topoppe/open-wales/README.md

# open-wales
Open-WaLeS: Ein Open-Source-IoT-System zur kurz- und langfristigen Überwachung von Binnenpegeln

Welcome to the official Github-Repo of the Open-WaLeS-System
