topoppe/open-wales/Basismodule/lorawan/firmware/readme.md

Sensor Firmware for LoRaWan Transmitter

Own Datatypes: 
0x00 -> 8 Bit FW-Version
0x01 -> 32 Bit Air-Pressure-Value 
0x02 -> 32 Bit Temperature-Value
0x03 -> 32 Bit Humidity-Value
