topoppe/open-wales/Sensormodule/Case/Sensormodul_Oberteil.stl

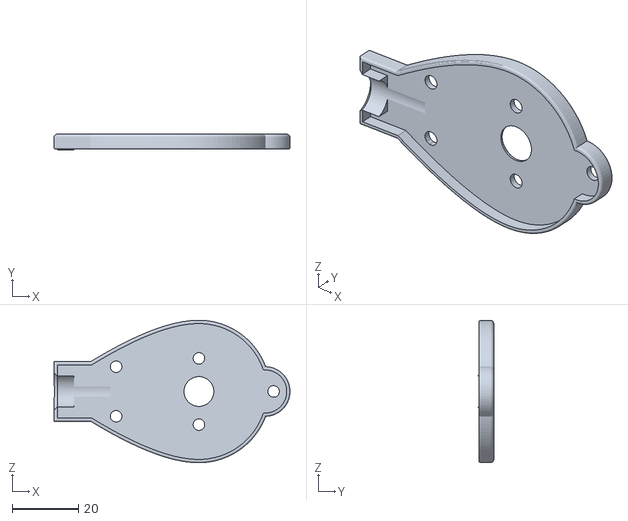
[picture p1: CAD file, 2023-01-30]
Sensormodule/Case/Sensormodul_Oberteil.stl
71.2 x 4.73 x 43.0
