topoppe/open-wales/Sensormodule/Case/Sensormodul_Unterteil.stl

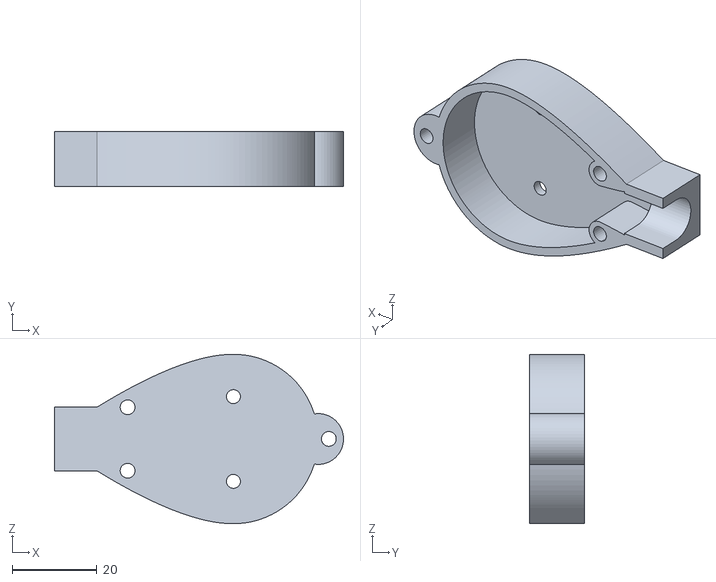
[picture p2: CAD file, 2023-01-30]
Sensormodule/Case/Sensormodul_Unterteil.stl
68.2 x 13.0 x 40.0
