topoppe/open-wales/Sensormodule/Case/Sensormodul_Rohr.stl

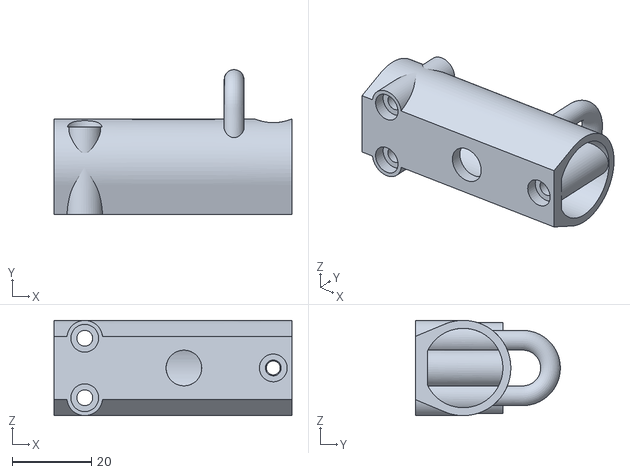
[picture p3: CAD file, 2023-01-30]
Sensormodule/Case/Sensormodul_Rohr.stl
60.0 x 36.5 x 24.0
