topoppe/open-wales/(list of files, cad)

Other CAD files:
Sensormodule/Case/sensor_case.f3d
