topoppe/open-wales/RS485_Interface/schematics_rs485_interface.pdf

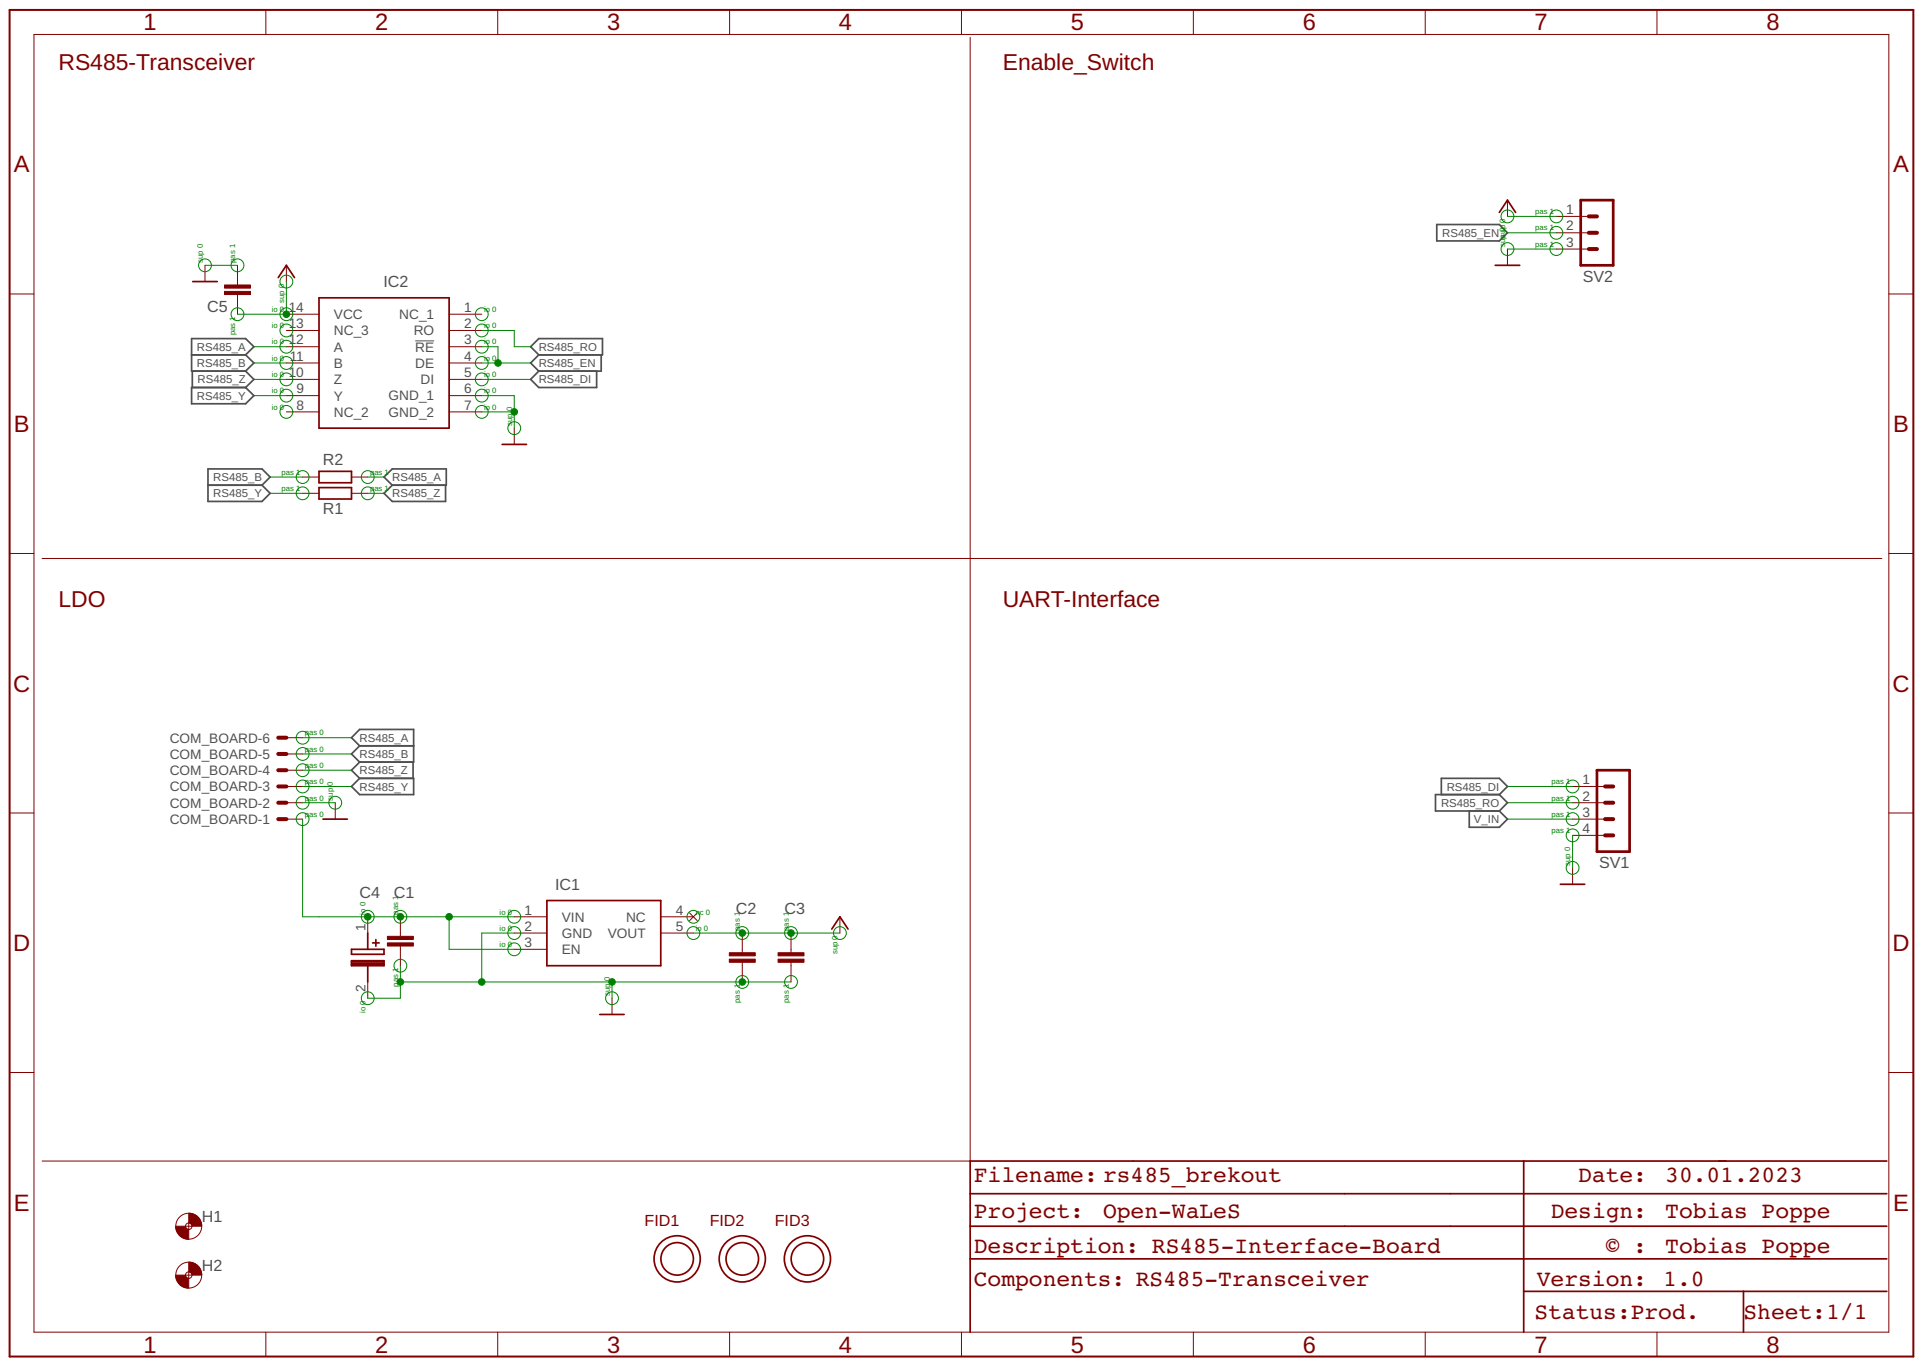
[picture p4: page 1]

Project: Open-WaLeS | Design: Tobias Poppe
Description: RS485-Interface-Board | © : Tobias Poppe
Components: RS485-Transceiver | Version: 1.0

Status: Prod. | Sheet: 1/1
