topoppe/open-wales/Basismodule/lorawan/schematics_basestation_lorawan.pdf

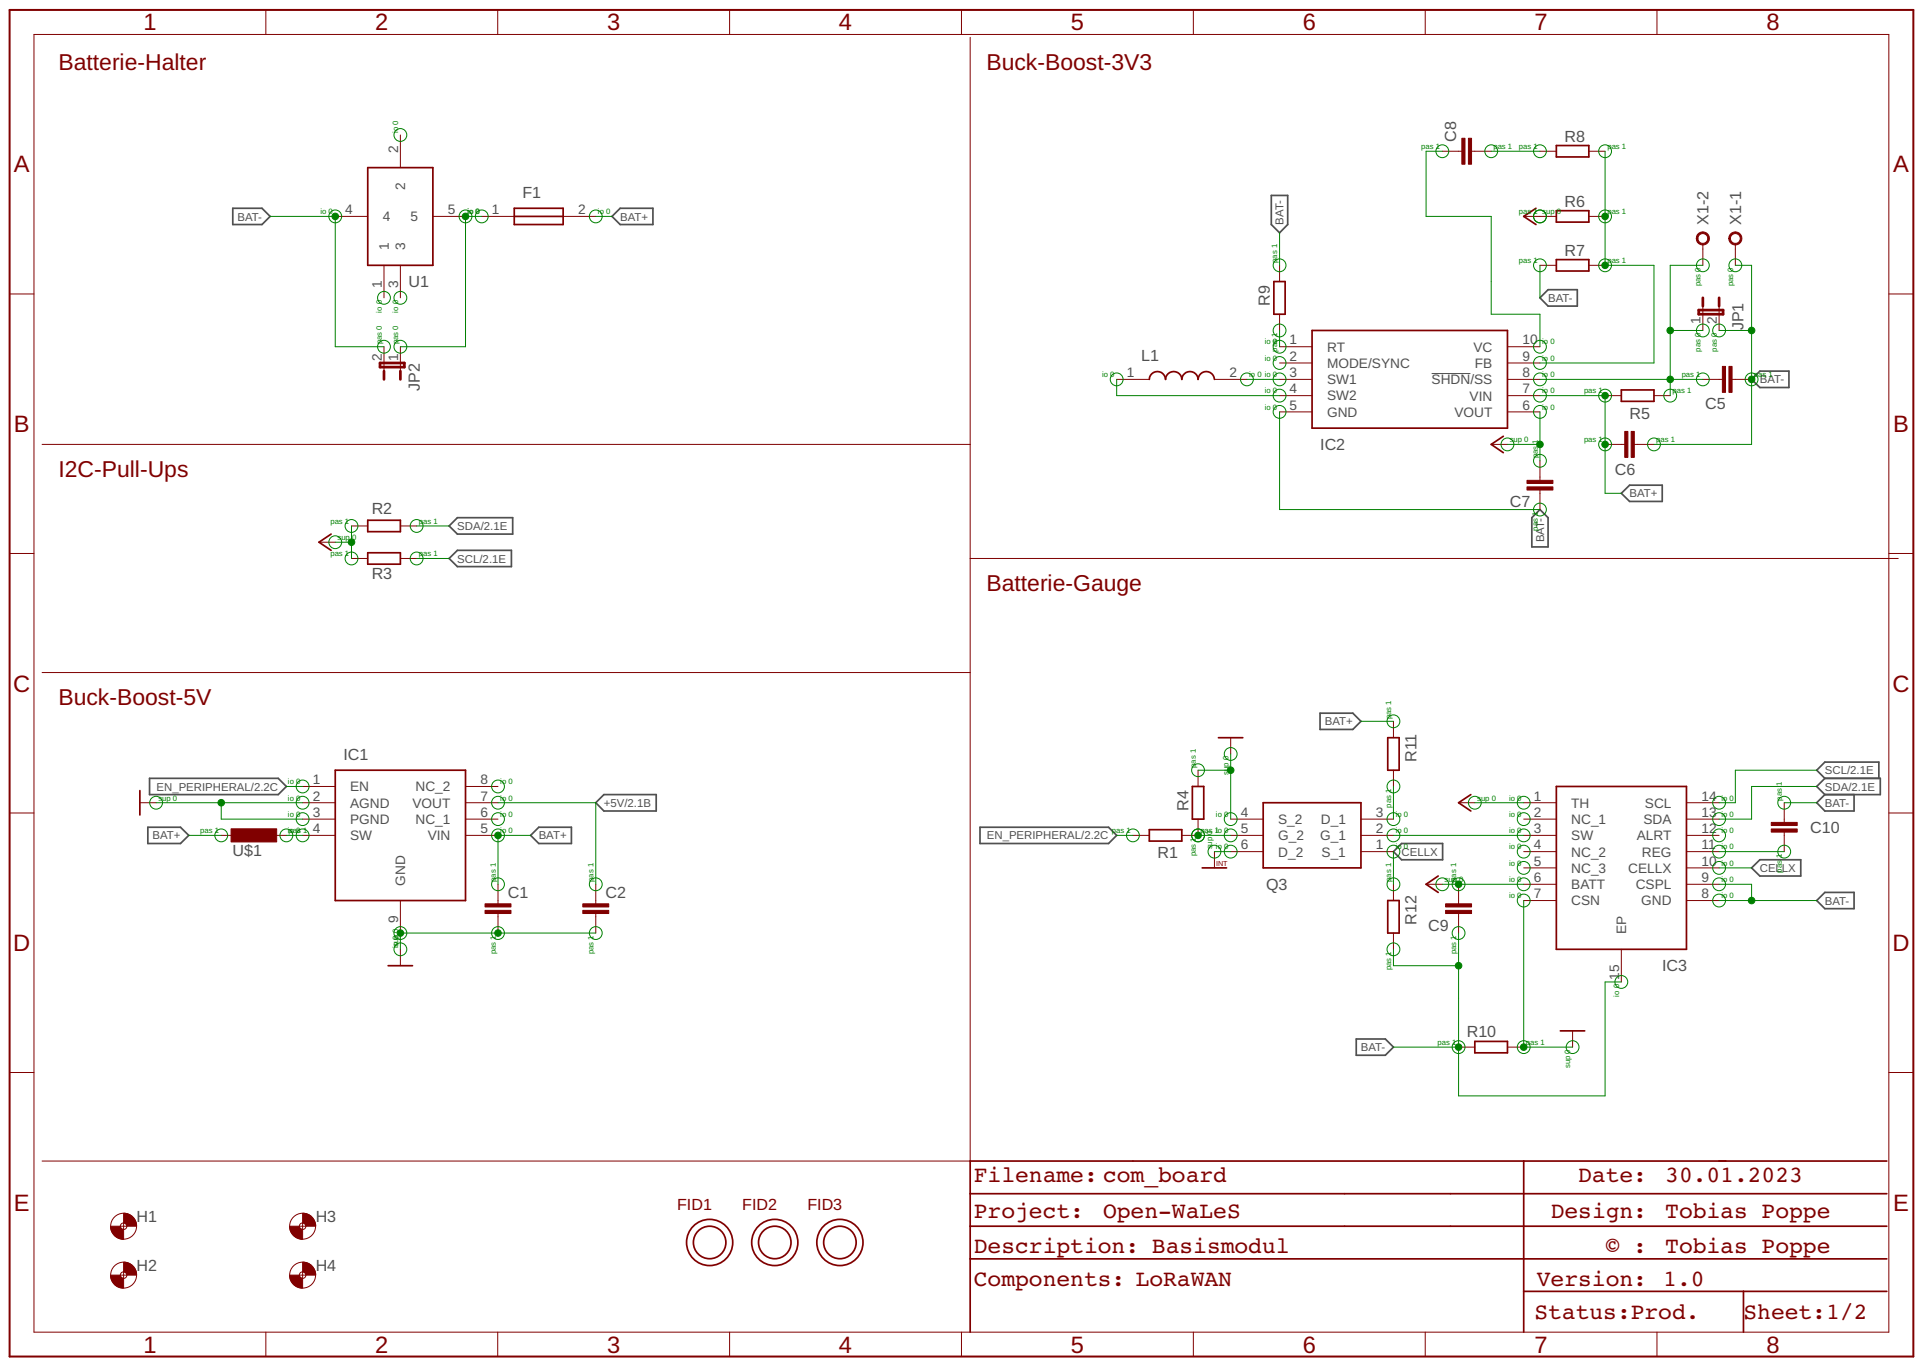
[picture p5: page 1]

pas 1 pas 1

Project: Open-WaLeS | Design: Tobias Poppe
Description: Basismodul | © : Tobias Poppe
Components: LoRaWAN | Version: 1.0

Status: Prod. | Sheet: 1/2

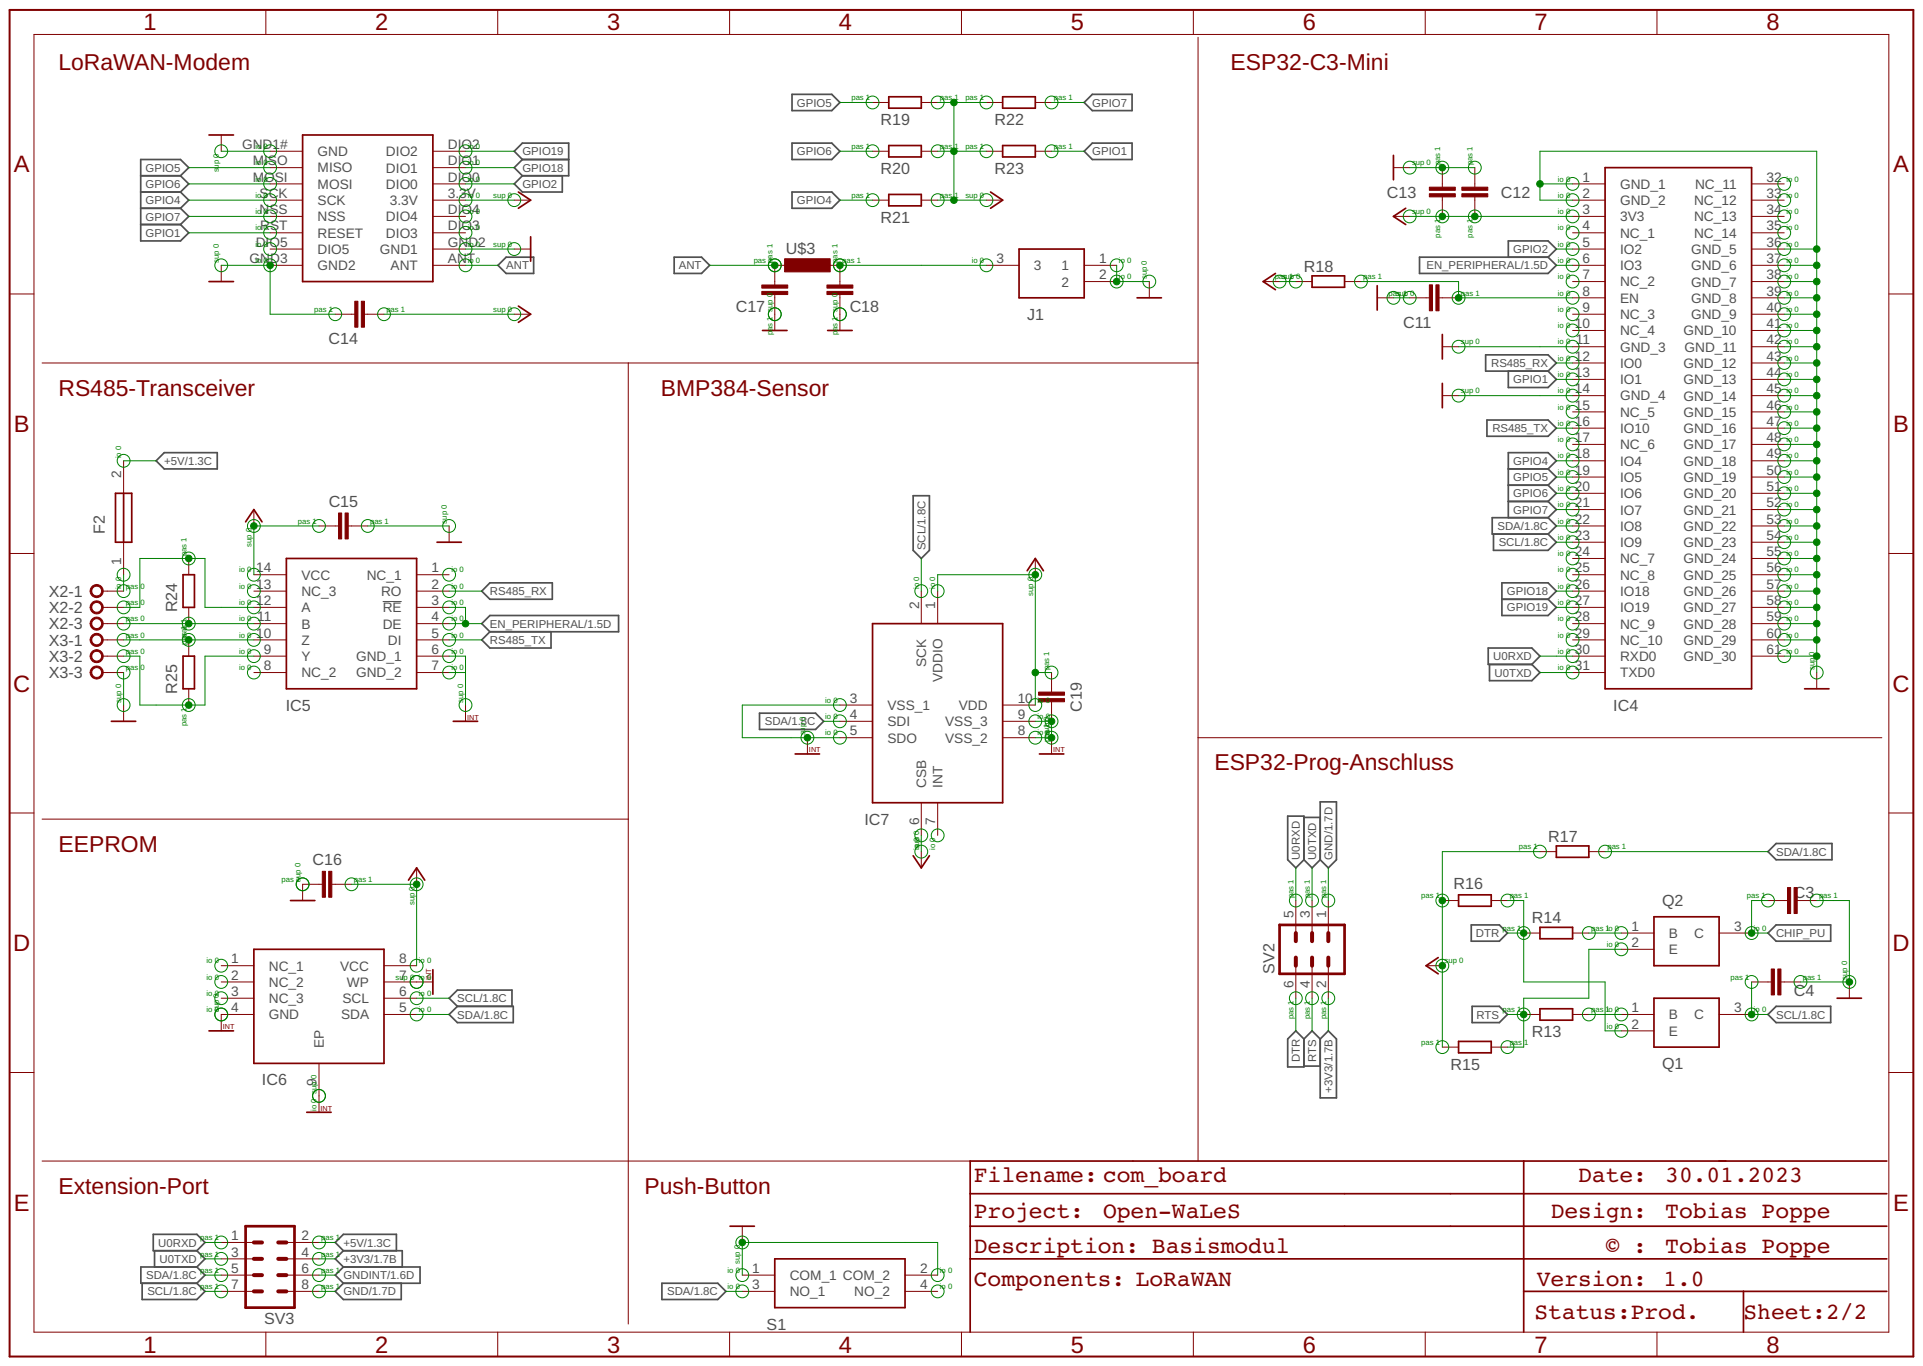
[picture p6: page 2]

LoRaWAN-Modem

pas 1 pas 1

Project: Open-WaLeS | Design: Tobias Poppe
Description: Basismodul | © : Tobias Poppe

SDA/1.8C | GNDINT/1.6D
SCL/1.8C | GND/1.7D

Status: Prod. | Sheet: 2/2
