topoppe/open-wales/Basismodule/nbiot/schematics_basestation_nbiot.pdf

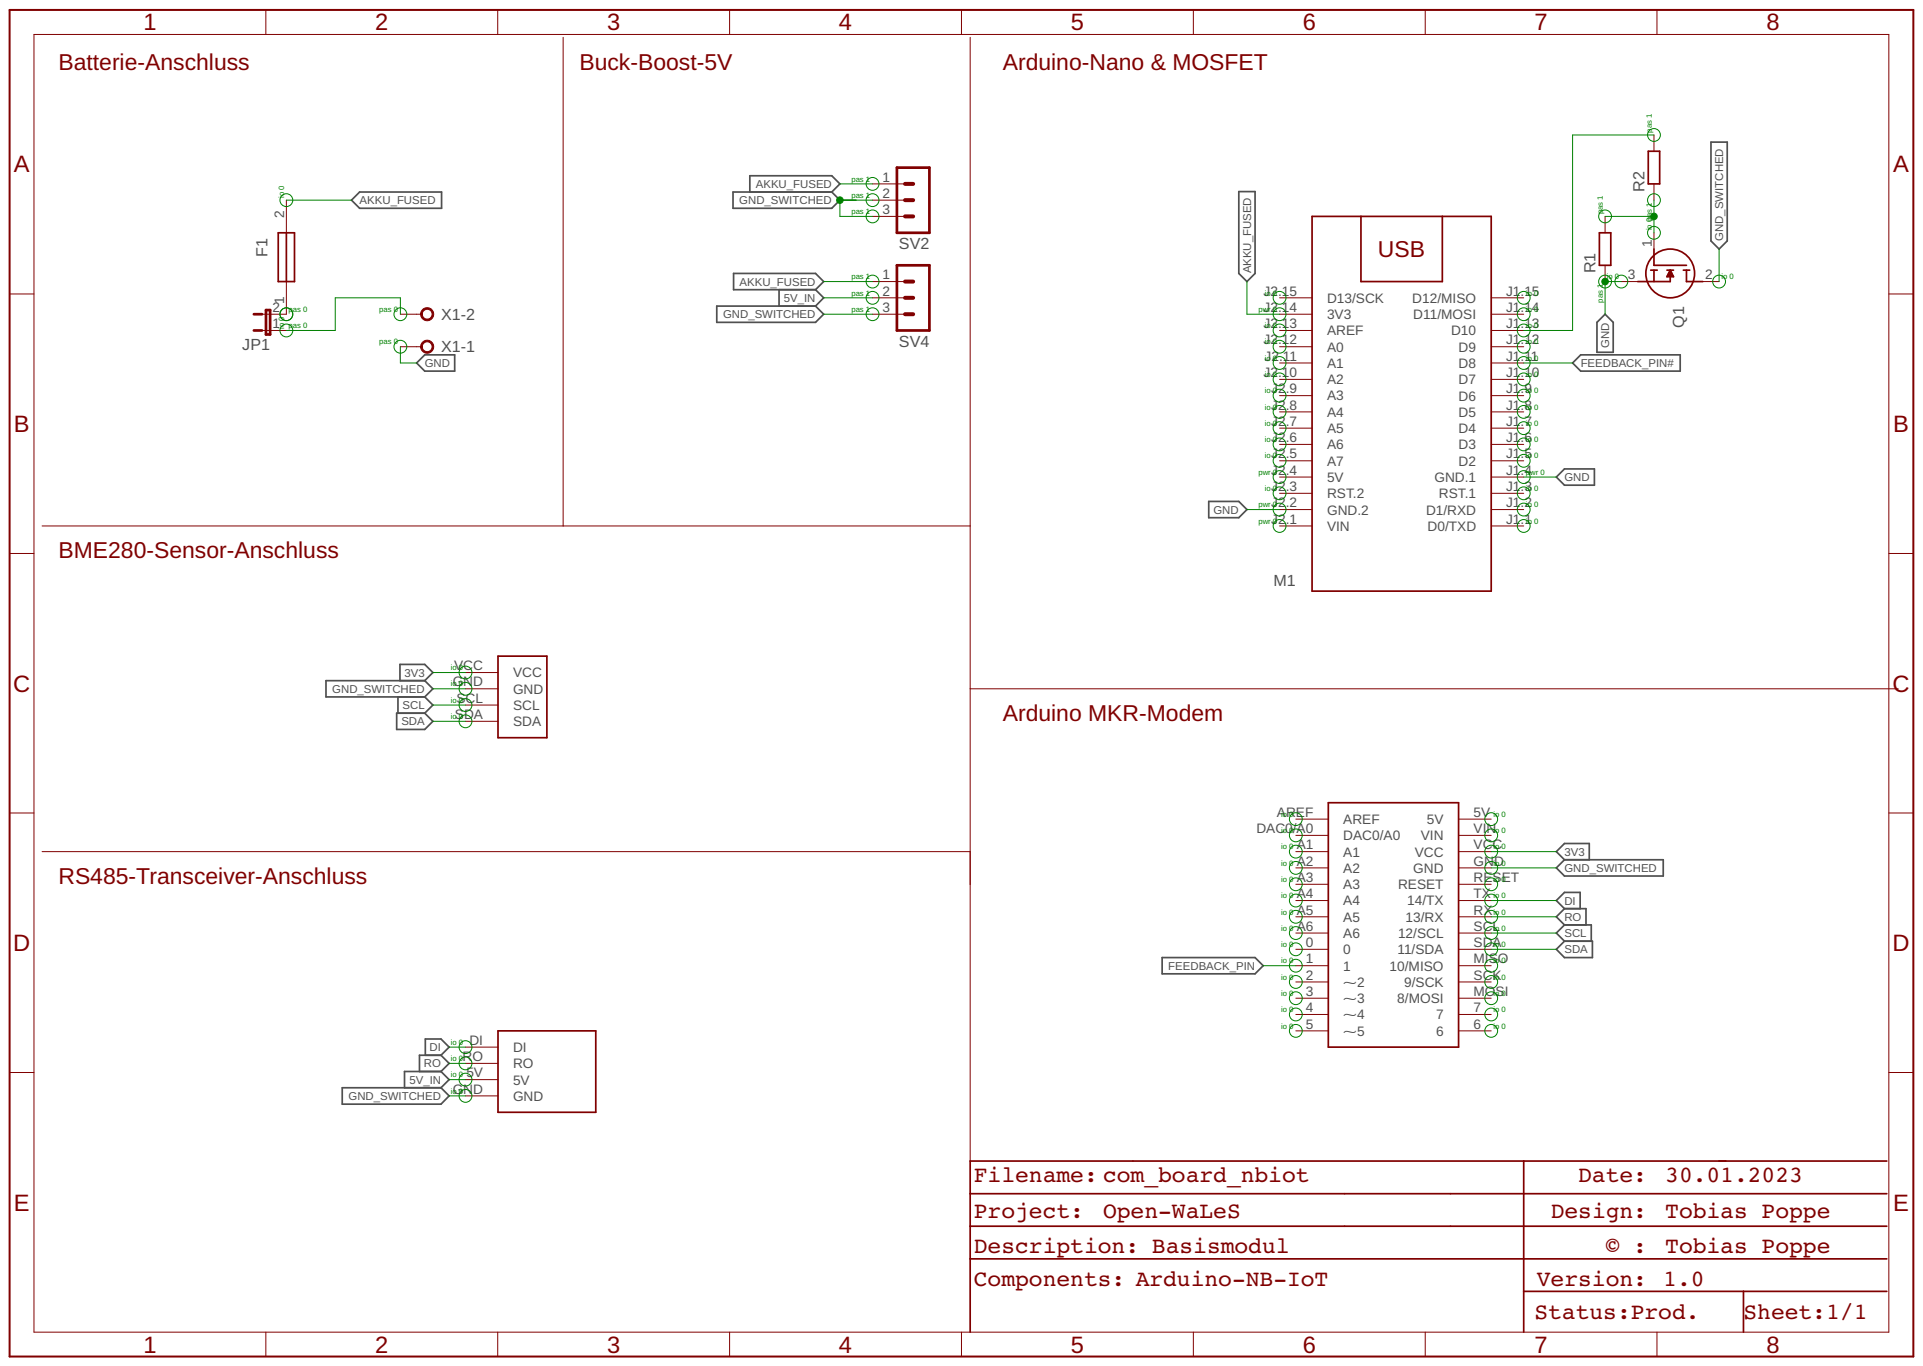
[picture p7: page 1]

Filename: com_board_nbiot | Date: 30.01.2023
Project: Open-WaLeS | Design: Tobias Poppe
Description: Basismodul | © : Tobias Poppe
Components: Arduino-NB-IoT | Version: 1.0

Status: Prod. | Sheet: 1/1
