topoppe/open-wales/Sensormodule/LPS28DFW/schematics_LPS28DFW.pdf

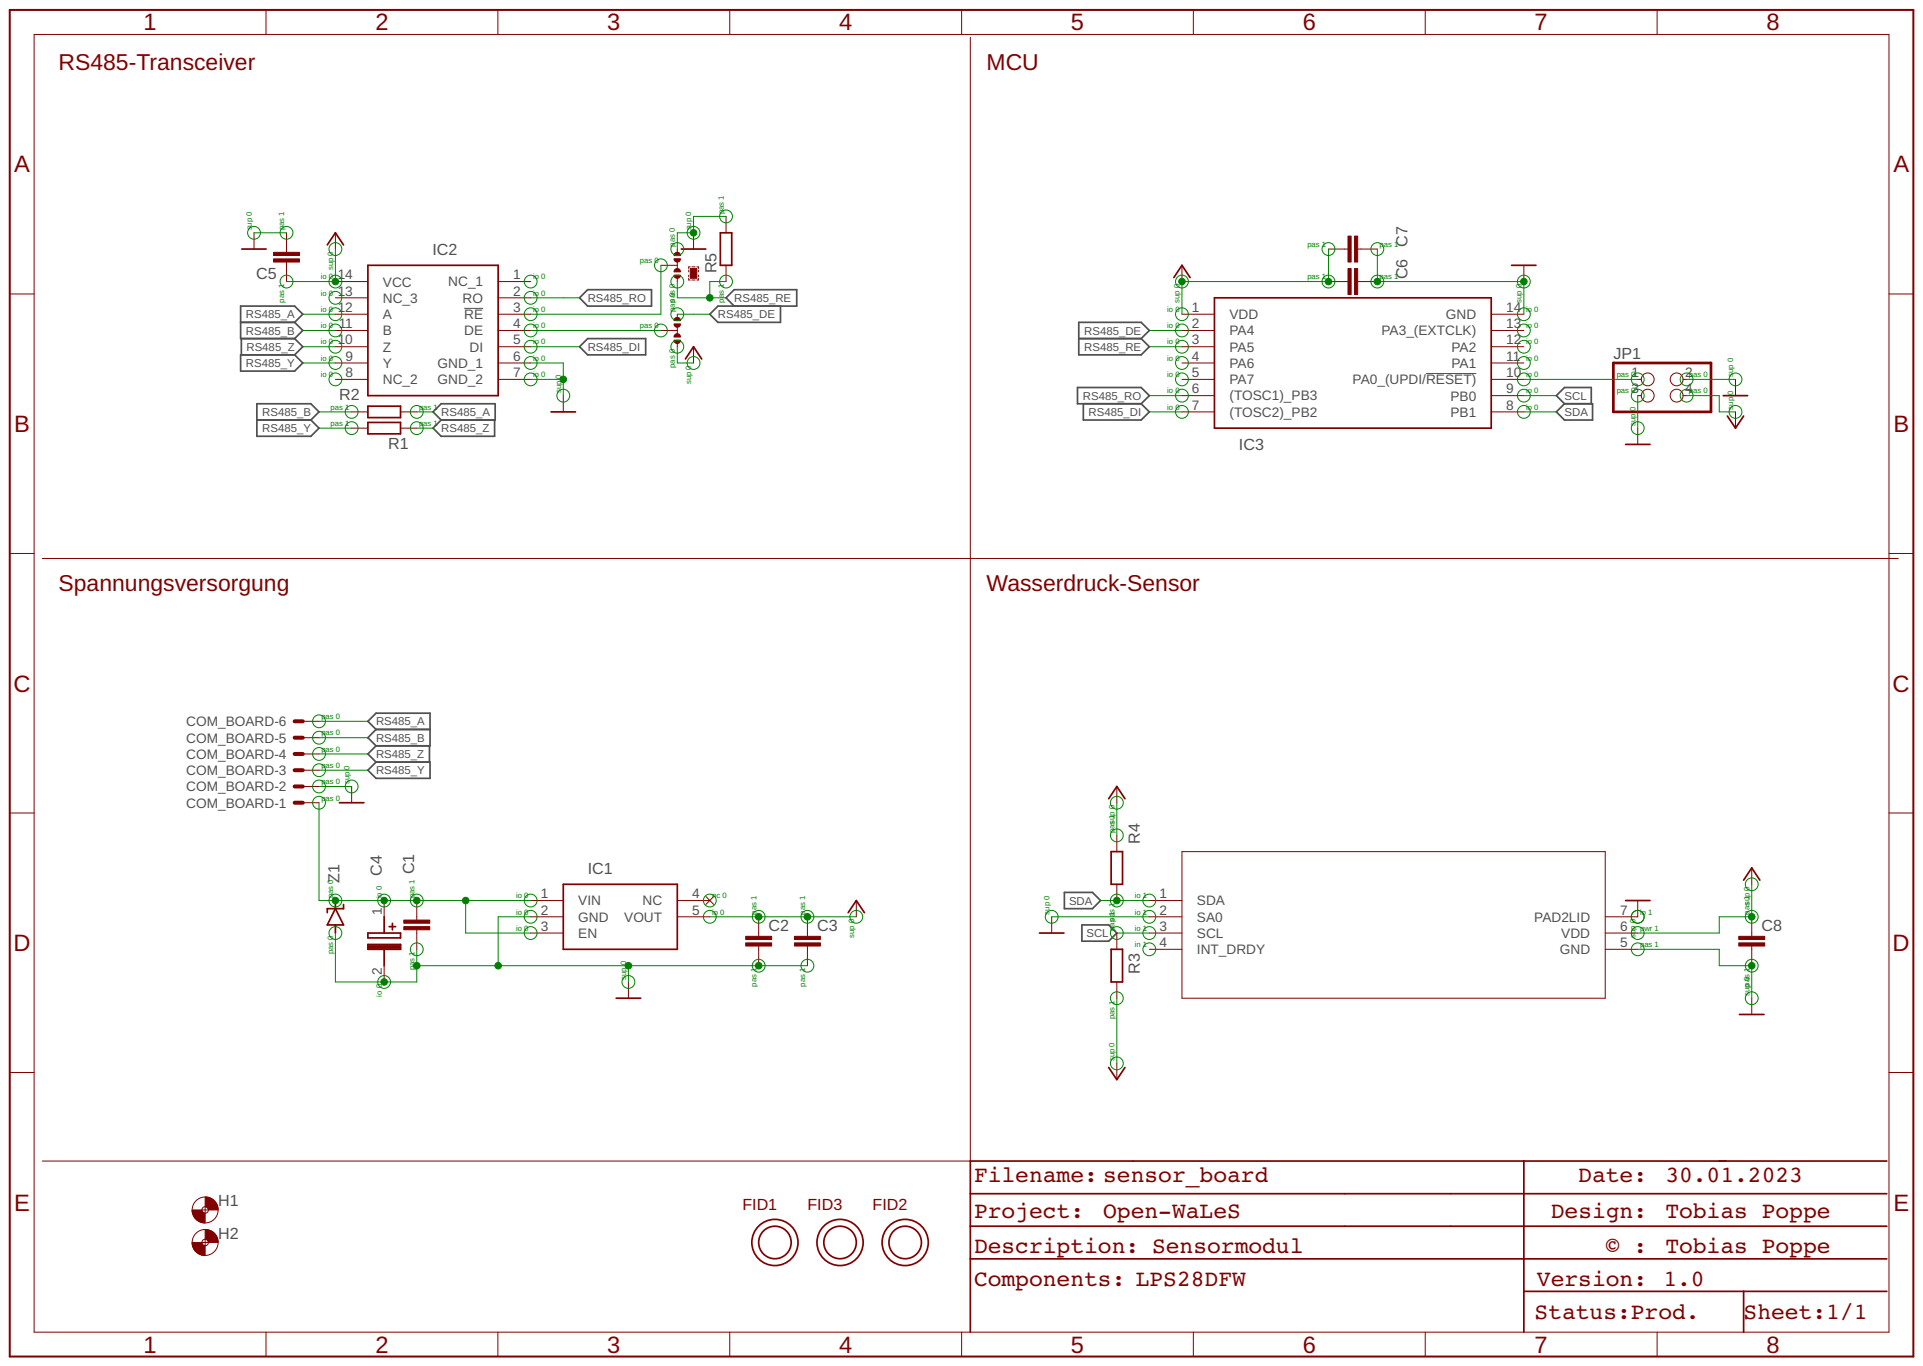
[picture p8: page 1]

pas 1 pas 1 pas 1 pas 1 sup 0 sup 0

pas 1 pas 1 sup 0 sup 0

H1 FID1 FID3 FID2 H2 | Filename: sensor_board | Date: 30.01.2023

Project: Open-WaLeS | Design: Tobias Poppe
Description: Sensormodul | © : Tobias Poppe
Components: LPS28DFW | Version: 1.0

Status: Prod. | Sheet: 1/1
