topoppe/open-wales/Sensormodule/MS5839/with_trubidity/schematics_ms5839_with_trub.pdf

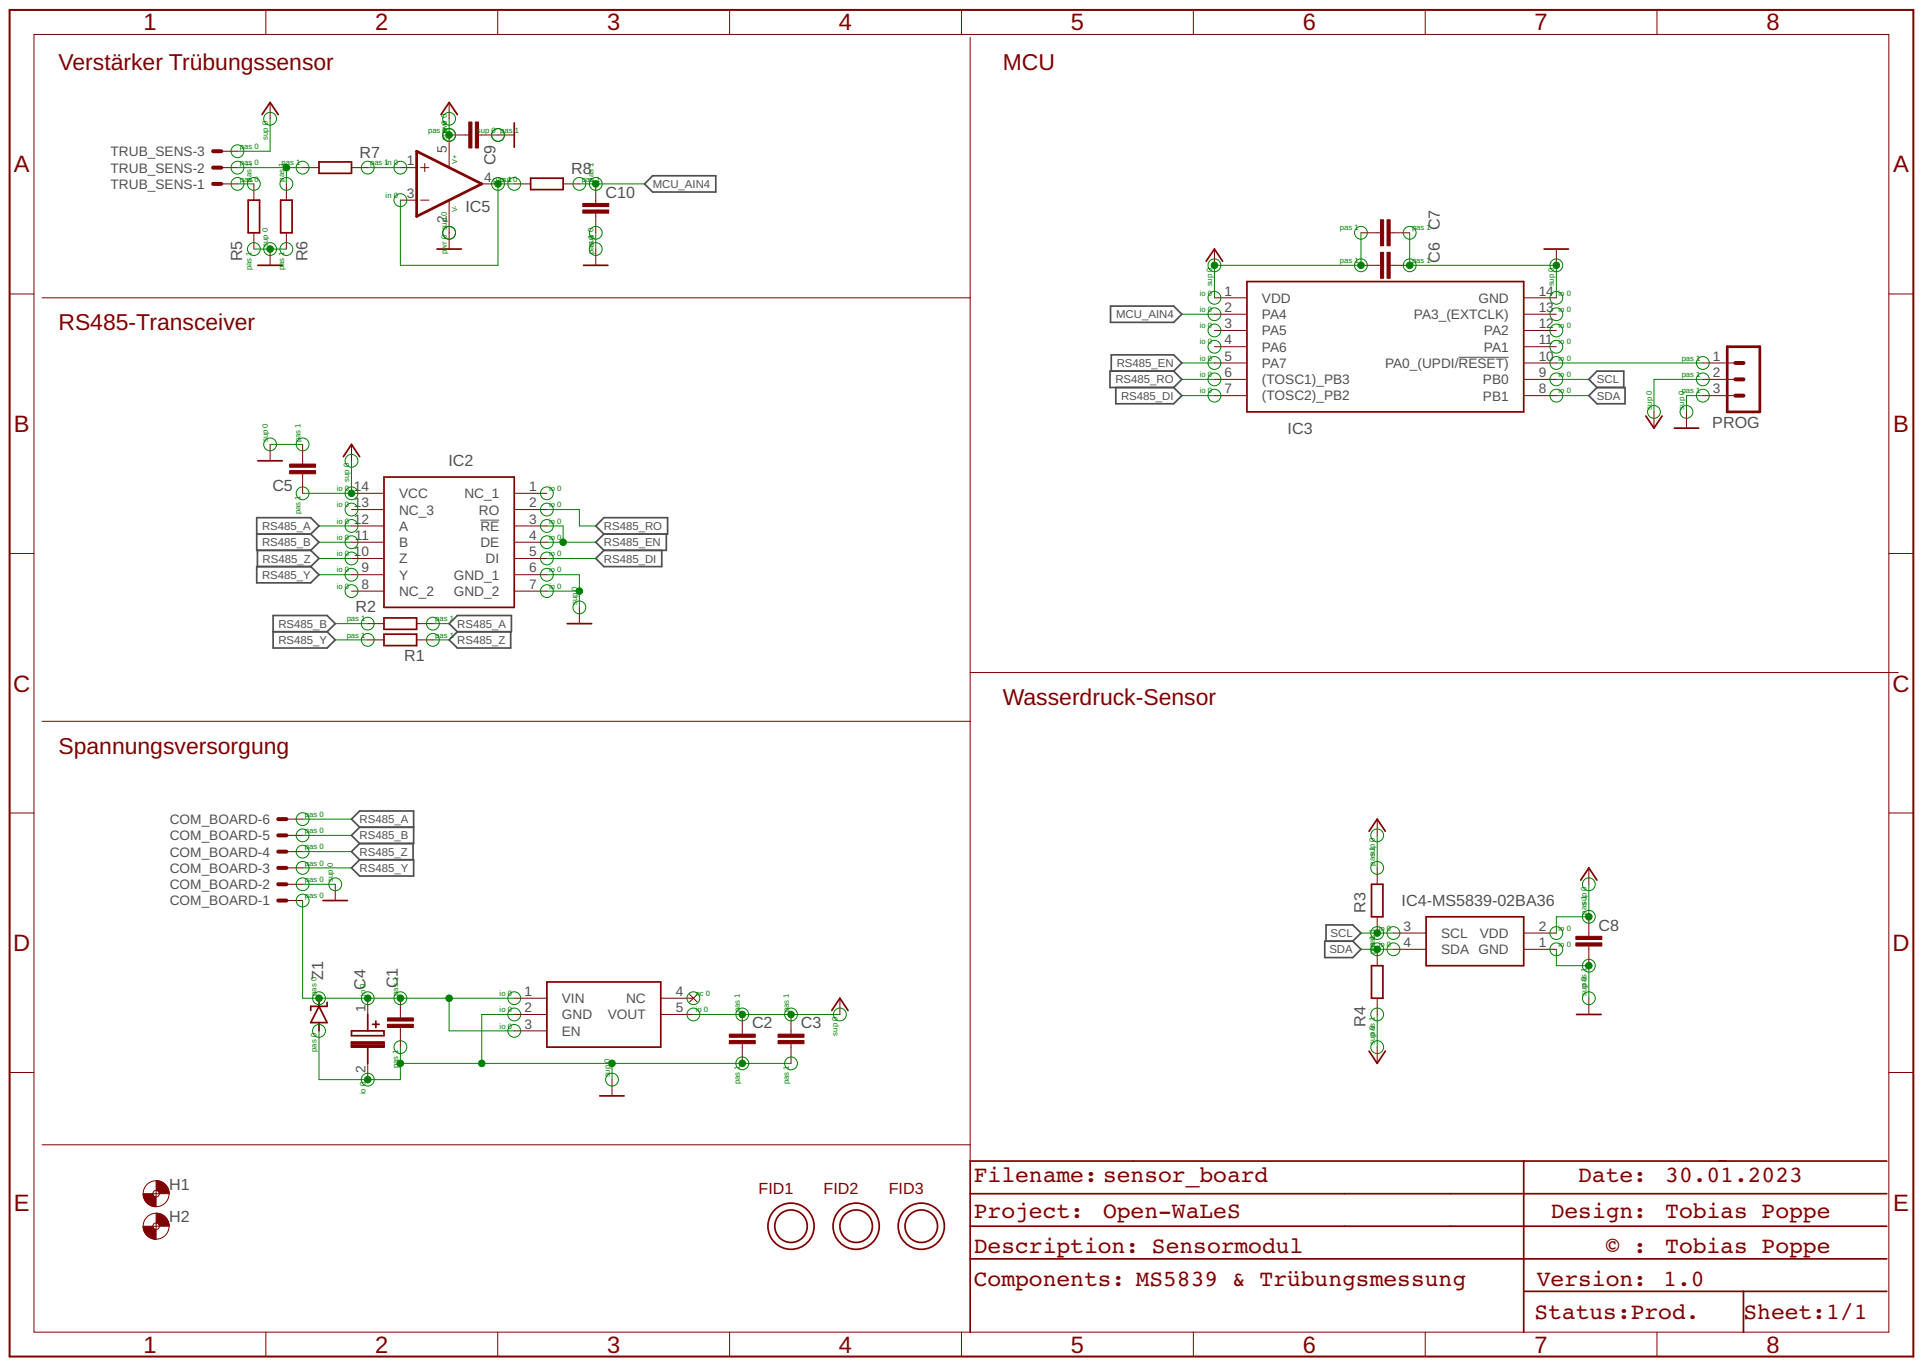
[picture p9: page 1]

pas 1 pas 1 pas 1 pas 1 sup 0 sup 0

pas 1 pas 1 sup 0 sup 0

Project: Open-WaLeS | Design: Tobias Poppe
Description: Sensormodul | © : Tobias Poppe
Components: MS5839 & Trübungsmessung | Version: 1.0

Status: Prod. | Sheet: 1/1
