topoppe/open-wales/RS485_Interface/rs485_interface.brd

## EAGLE design RS485_Interface/rs485_interface.brd (2023-01-30)

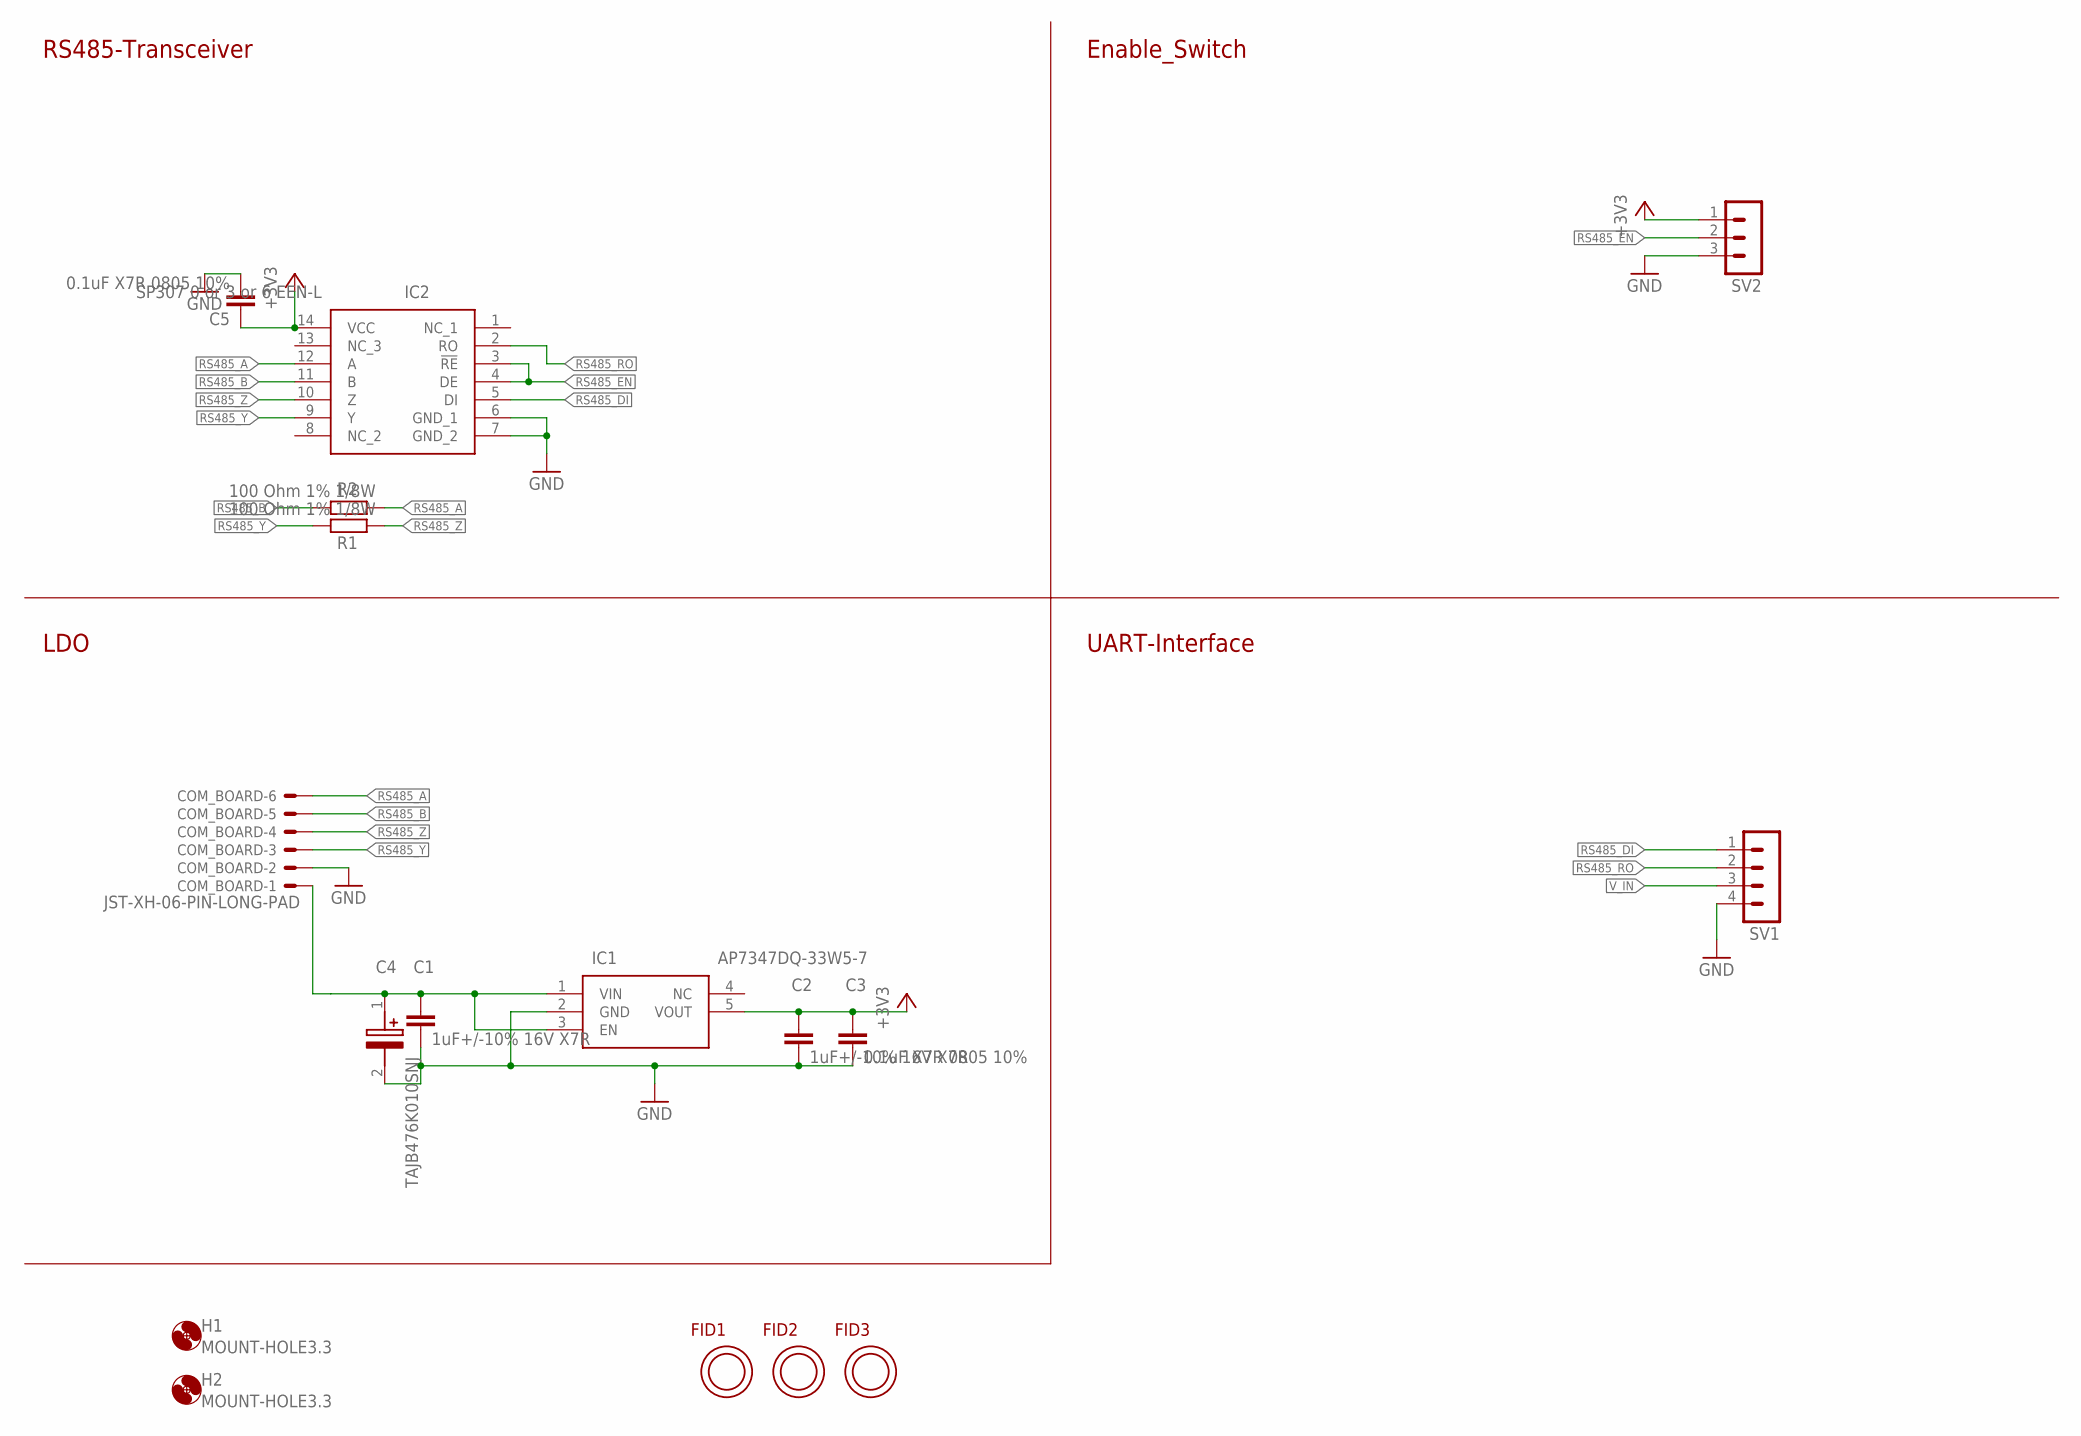
[picture p10: schematic rs485_interface.sch]

Parts:
C1, C2: 1uF+/-10% 16V X7R; C0805
C3, C5: 0.1uF X7R 0805 10%; C0805
C4: TAJB476K010SNJ; CAPPM3528X210N
COM_BOARD: JST-XH-06-PIN-LONG-PAD; JST-XH-06-PACKAGE-LONG-PAD
FID1, FID2, FID3: OPEN-PNP-FIDUCIAL
H1, H2: MOUNT-HOLE3.3; 3,3
IC1: AP7347DQ-33W5-7; SOT95P280X145-5N
IC2: SP307 0 or 3 or 6 EEN-L; SOIC127P600X175-14N
R1, R2: 100 Ohm 1% 1/8W; R0805
SV1: MA04-1
SV2: MA03-1

Connections:
+3V3: C2.1, C3.1, C5.1, IC1.5 (VOUT), IC2.14 (VCC), SV2.1
GND: C1.2, C2.2, C3.2, C4.2 (-), C5.2, COM_BOARD.2, IC1.2 (GND), IC2.6 (GND_1), IC2.7 (GND_2), SV1.4, SV2.3
RS485_A: COM_BOARD.6, IC2.12 (A), R2.1
RS485_B: COM_BOARD.5, IC2.11 (B), R2.2
RS485_DI: IC2.5 (DI), SV1.1
RS485_EN: IC2.3 (!RE), IC2.4 (DE), SV2.2
RS485_RO: IC2.2 (RO), SV1.2
RS485_Y: COM_BOARD.3, IC2.9 (Y), R1.2
RS485_Z: COM_BOARD.4, IC2.10 (Z), R1.1
V_IN: C1.1, C4.1 (+), COM_BOARD.1, IC1.1 (VIN), IC1.3 (EN), SV1.3

Notes on the sheet:
RS485-Transceiver
LDO
Enable_Switch
UART-Interface

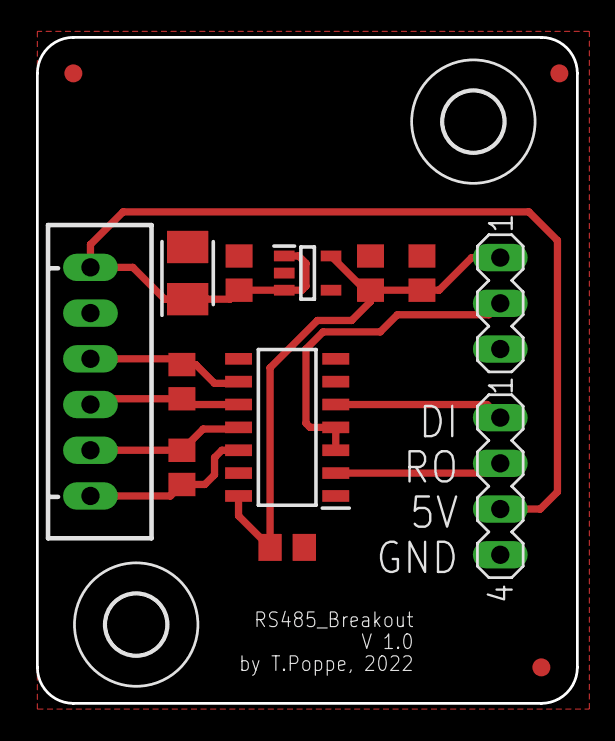
[picture p11: board rs485_interface.brd from above]

Board: 2 copper layers, 30.0 x 37.0 mm, 17 parts (0 on the bottom side), 10 nets.
