topoppe/open-wales/Basismodule/nbiot/basestation_nbiot.brd

## EAGLE design Basismodule/nbiot/basestation_nbiot.brd (2023-01-30)

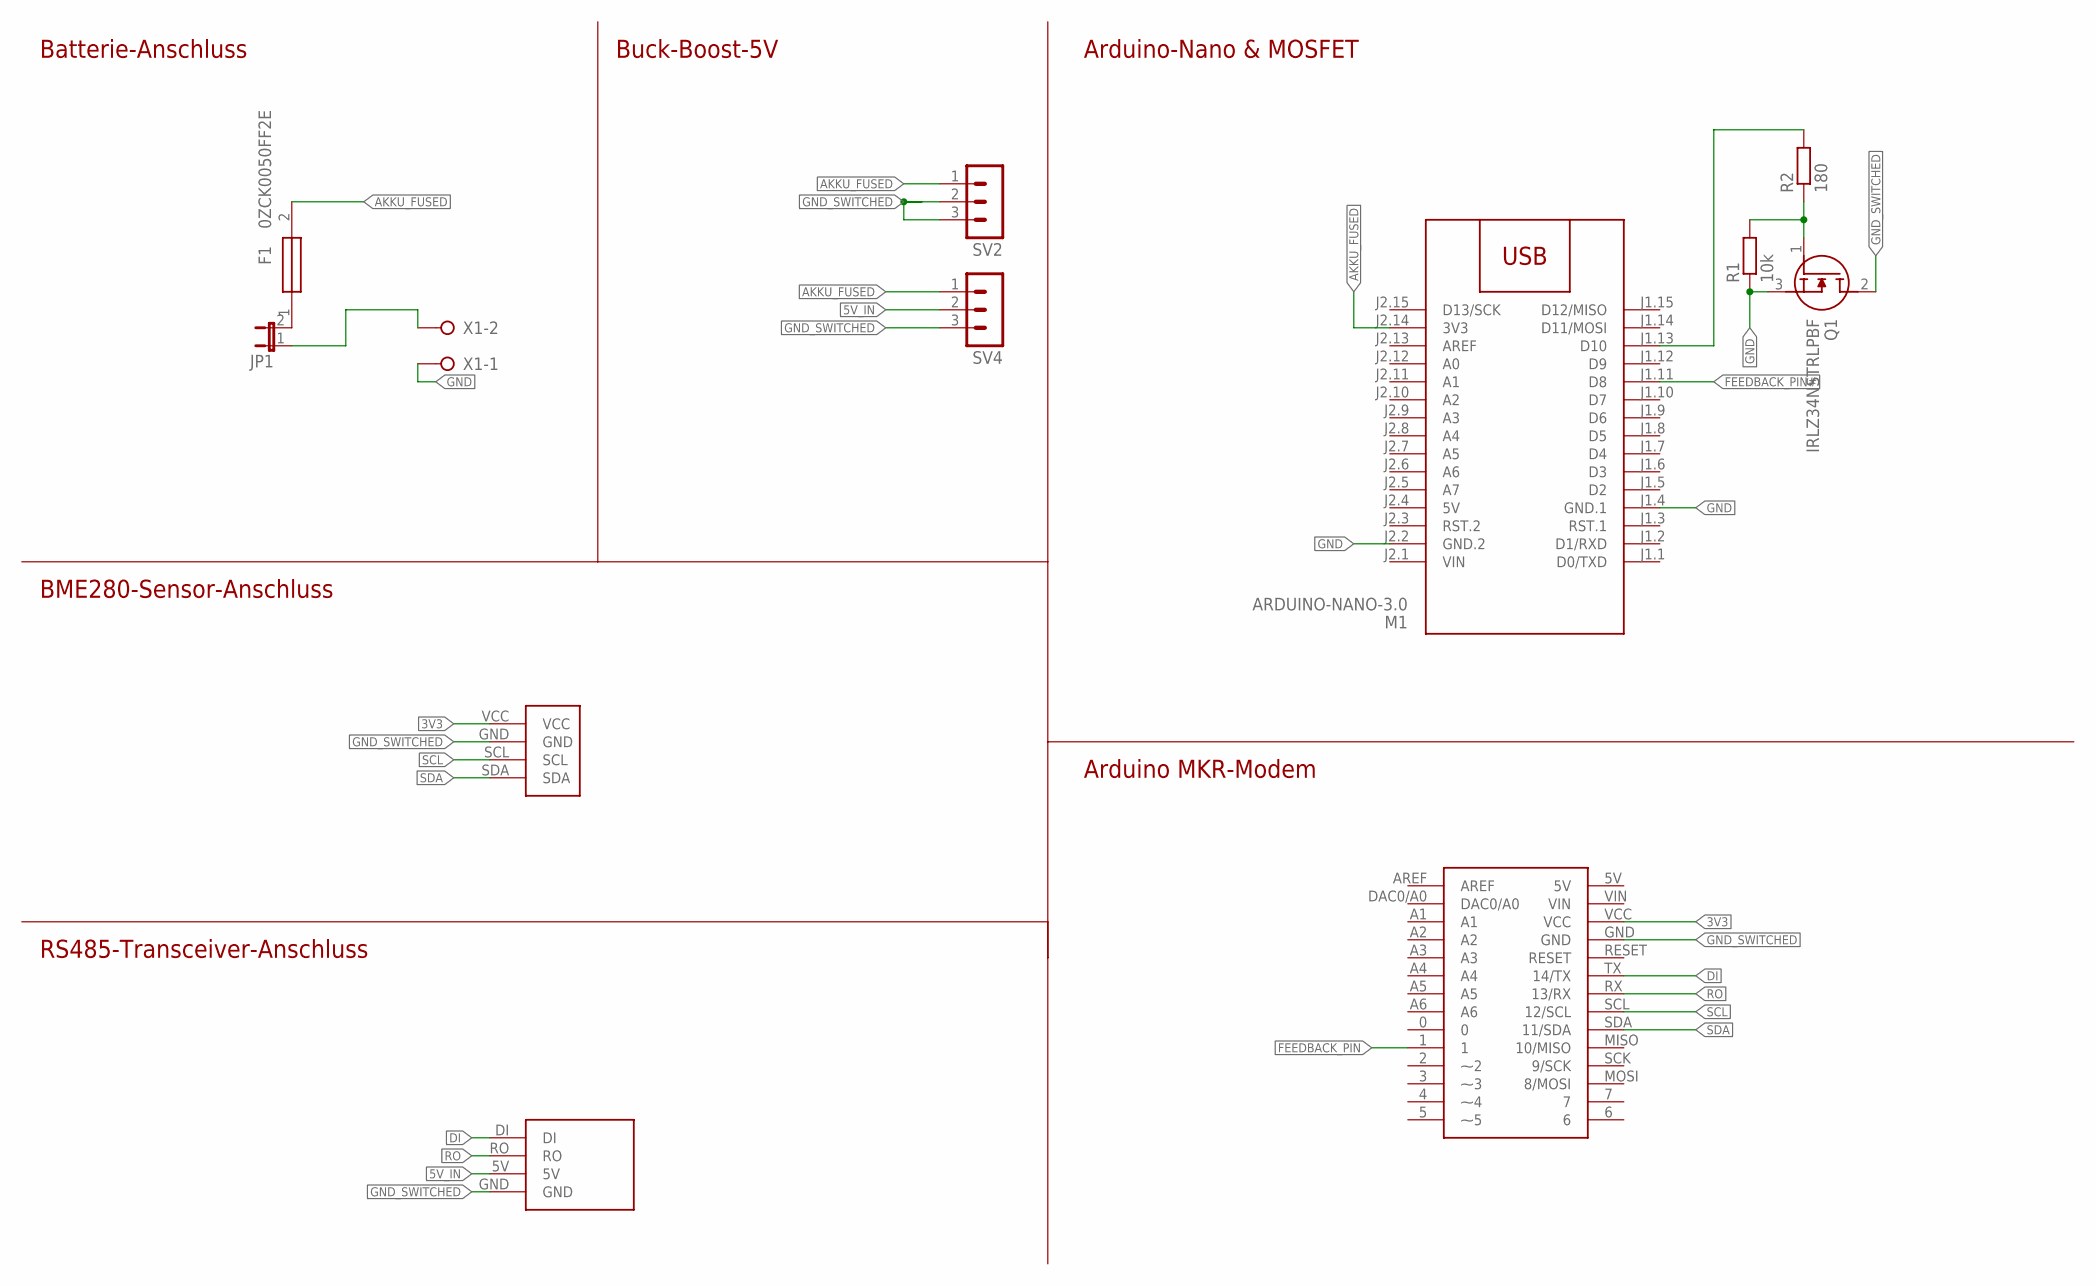
[picture p12: schematic basestation_nbiot.sch]

Parts:
F1: 0ZCK0050FF2E; FUSC2214X125N
JP1: JP1E; JP1
M1: ARDUINO-NANO-3.0
Q1: IRLZ34NSTRLPBF; D2PAK
R1: 10k; R1206
R2: 180; R1206
SV2, SV4: MA03-1
U$1: ARDUINO_GSM_MKR_1400; ARDUINO_GSM_MKR1400
U$2: BME280-BREAKOUT
U$3: RS485_PEGEL_BREAKOUT
X1: W237-02P; W237-132

Connections:
3V3: U$1.VCC, U$2.VCC
5V: M1.J2.4 (5V)
5V_IN: SV4.2, U$3.5V
AKKU_FUSED: F1.2, M1.J2.14 (3V3), SV2.1, SV4.1
AKKU_UNFUSED: JP1.1, X1.2
DI: U$1.TX (14/TX), U$3.DI
FEEDBACK_PIN: U$1.1
FEEDBACK_PIN#: M1.J1.11 (D8)
GND: M1.J1.4 (GND.1), M1.J2.2 (GND.2), Q1.3 (S), R1.1, X1.1
GND_SWITCHED: Q1.2 (D), SV2.2, SV2.3, SV4.3, U$1.GND, U$2.GND, U$3.GND
unnamed: M1.J1.13 (D10), R2.2
unnamed: Q1.1 (G), R1.2, R2.1
unnamed: F1.1, JP1.2
RO: U$1.RX (13/RX), U$3.RO
SCL: U$1.SCL (12/SCL), U$2.SCL
SDA: U$1.SDA (11/SDA), U$2.SDA
VIN: M1.J2.1 (VIN)

Notes on the sheet:
Batterie-Anschluss
Buck-Boost-5V
BME280-Sensor-Anschluss
RS485-Transceiver-Anschluss
Arduino-Nano & MOSFET
Arduino MKR-Modem

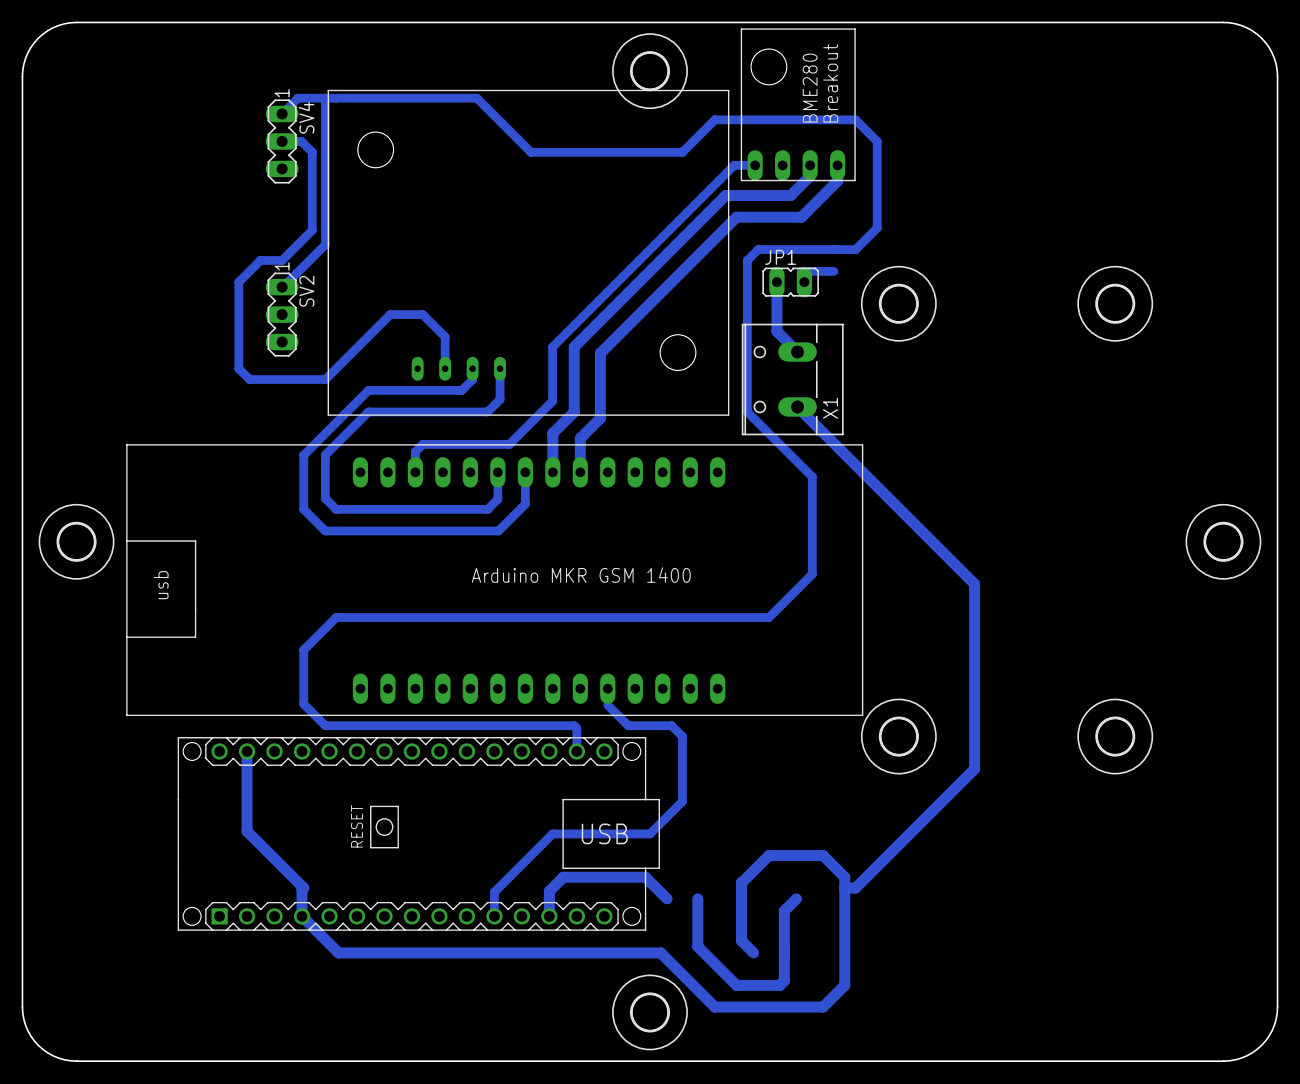
[picture p13: board basestation_nbiot.brd from above]

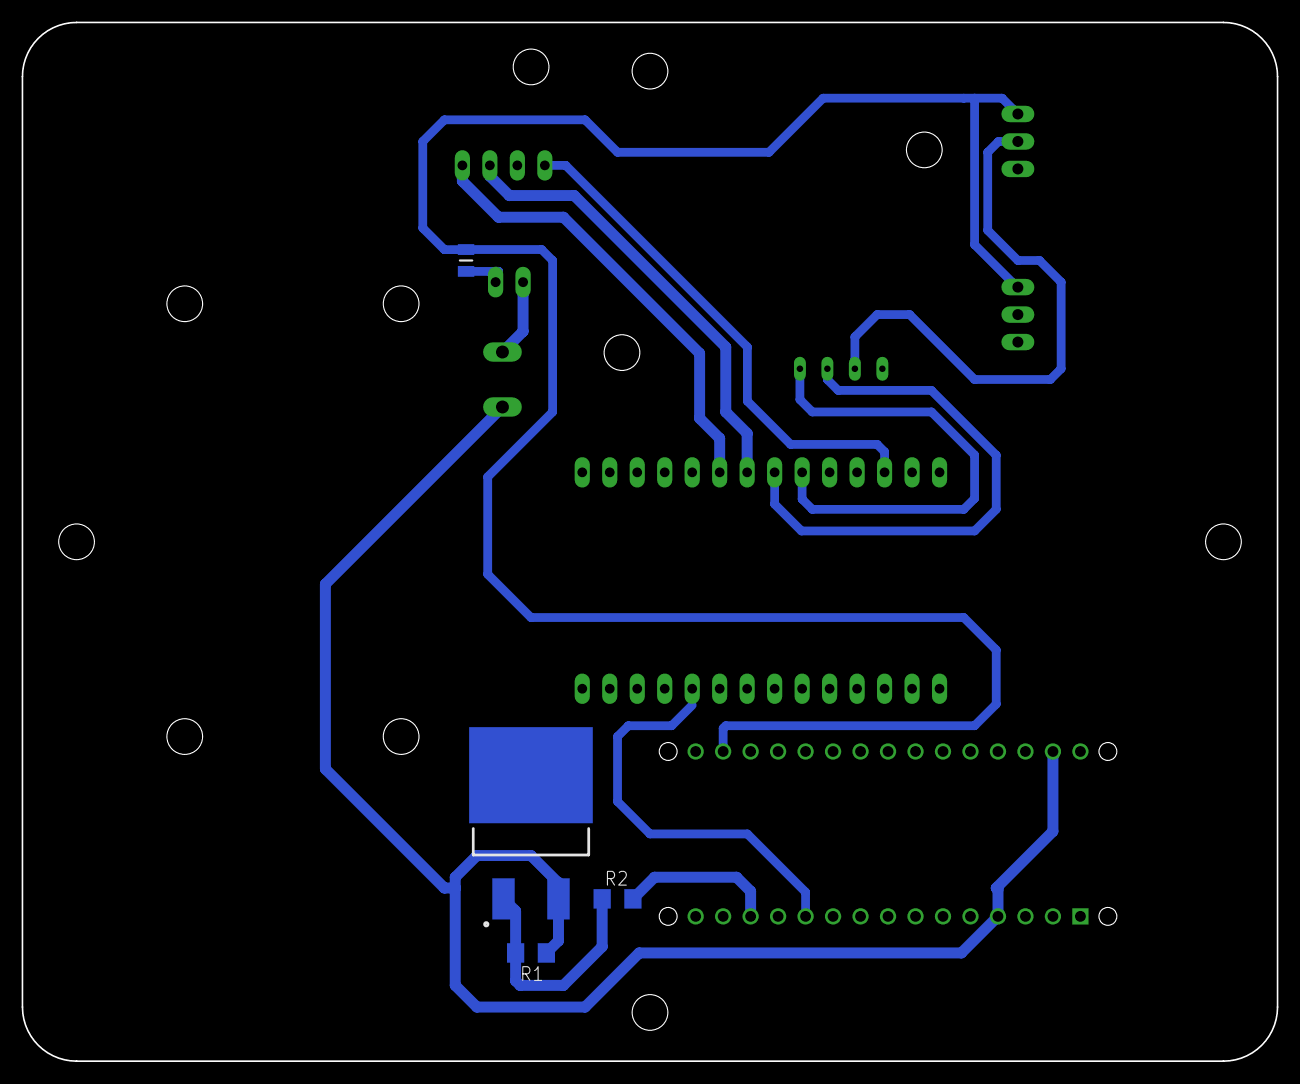
[picture p14: board basestation_nbiot.brd from below]

Board: 2 copper layers, 116.0 x 96.0 mm, 20 parts (4 on the bottom side), 13 nets.

Other parts of the board:
U$4, U$5, U$6, U$7, U$8, U$9, U$12, U$13: 3,3
