topoppe/open-wales/Sensormodule/MS5839/without_trubidity/ms5839_without_trub.brd

## EAGLE design Sensormodule/MS5839/without_trubidity/ms5839_without_trub.brd (2023-01-30)

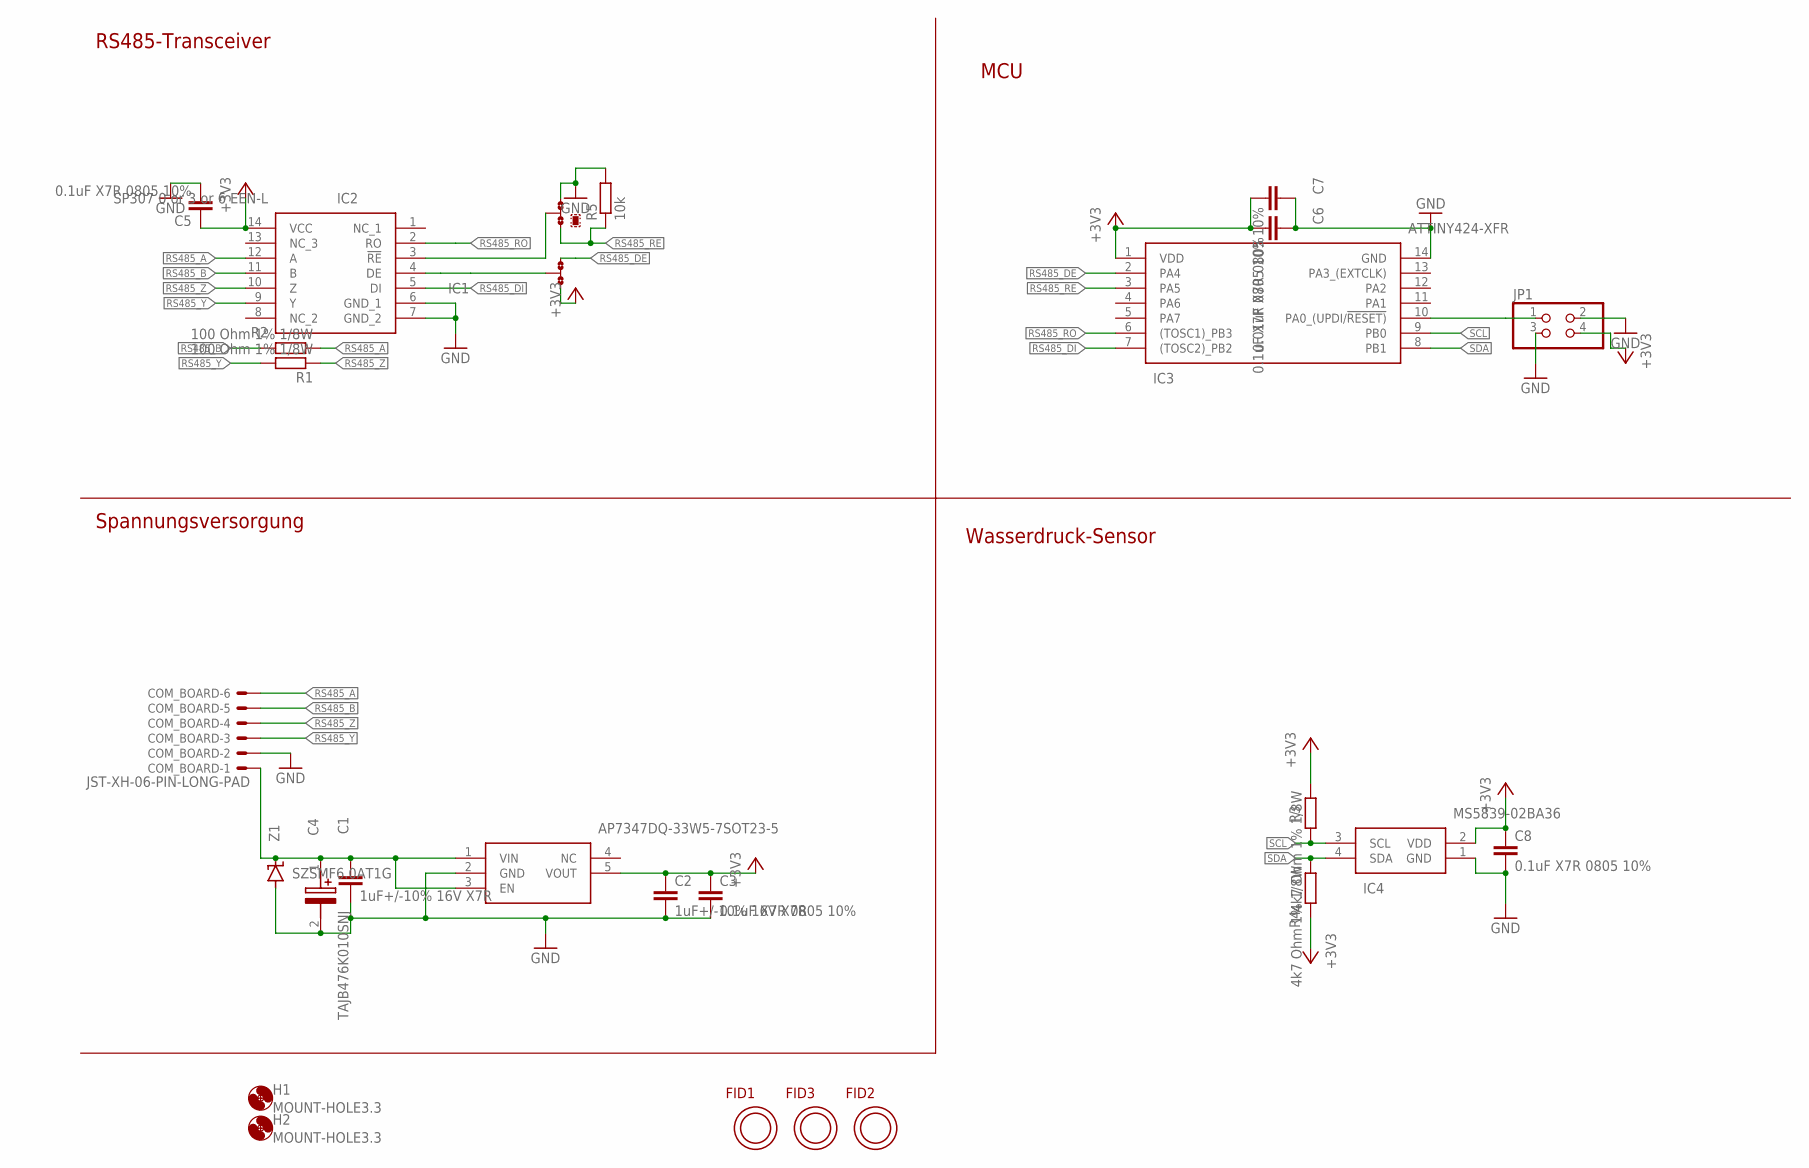
[picture p15: schematic ms5839_without_trub.sch]

Parts:
C1, C2: 1uF+/-10% 16V X7R; C0805
C3, C5, C6, C8: 0.1uF X7R 0805 10%; C0805
C4: TAJB476K010SNJ; CAPPM3528X210N
C7: 0.01uF X7R 0805 10%; C0805
COM_BOARD: JST-XH-06-PIN-LONG-PAD; JST-XH-06-PACKAGE-LONG-PAD
FID1, FID2, FID3: OPEN-PNP-FIDUCIAL
H1, H2: MOUNT-HOLE3.3; 3,3
IC1: AP7347DQ-33W5-7SOT23-5; SOT95P240X110-5N
IC2: SP307 0 or 3 or 6 EEN-L; SOIC127P600X175-14N
IC3: ATTINY424-XFR; SOP65P640X120-14N
IC4: MS5839-02BA36; MS583902BA36
JMP1, JMP2: 0R-JUMPA; A0R-JMP
JP1: PINHD-2X2; 2X02
R1, R2: 100 Ohm 1% 1/8W; R0805
R3, R4: 4k7 Ohm 1% 1/8W; R0805
R5: 10k; M0805
Z1: SZSMF6.0AT1G; SOD123

Connections:
!RE: IC2.3 (!RE), JMP2.2
+3V3: C2.1, C3.1, C5.1, C6.2, C7.2, C8.1, IC1.5 (VOUT), IC2.14 (VCC), IC3.1 (VDD), IC4.2 (VDD), JMP1.1, JP1.4, R3.1, R4.2
DE: IC2.4 (DE), JMP1.2
GND: C1.2, C2.2, C3.2, C4.2 (-), C5.2, C6.1, C7.1, C8.2, COM_BOARD.2, IC1.2 (GND), IC2.6 (GND_1), IC2.7 (GND_2), IC3.14 (GND), IC4.1 (GND), JMP2.3, JP1.2, JP1.3, R5.2, Z1.A
unnamed: C1.1, C4.1 (+), COM_BOARD.1, IC1.1 (VIN), IC1.3 (EN), Z1.C
unnamed: IC3.10 (PA0_(UPDI/!RESET)), JP1.1
RS485_A: COM_BOARD.6, IC2.12 (A), R2.1
RS485_B: COM_BOARD.5, IC2.11 (B), R2.2
RS485_DE: IC3.2 (PA4), JMP1.3
RS485_DI: IC2.5 (DI), IC3.7 ((TOSC2)_PB2)
RS485_RE: IC3.3 (PA5), JMP2.1, R5.1
RS485_RO: IC2.2 (RO), IC3.6 ((TOSC1)_PB3)
RS485_Y: COM_BOARD.3, IC2.9 (Y), R1.2
RS485_Z: COM_BOARD.4, IC2.10 (Z), R1.1
SCL: IC3.9 (PB0), IC4.3 (SCL), R3.2
SDA: IC3.8 (PB1), IC4.4 (SDA), R4.1

Notes on the sheet:
RS485-Transceiver
Spannungsversorgung
MCU
Wasserdruck-Sensor

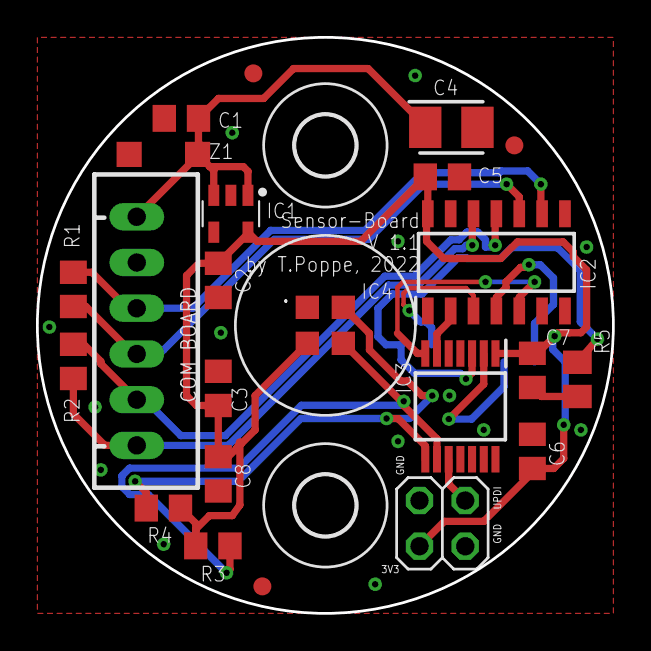
[picture p16: board ms5839_without_trub.brd from above]

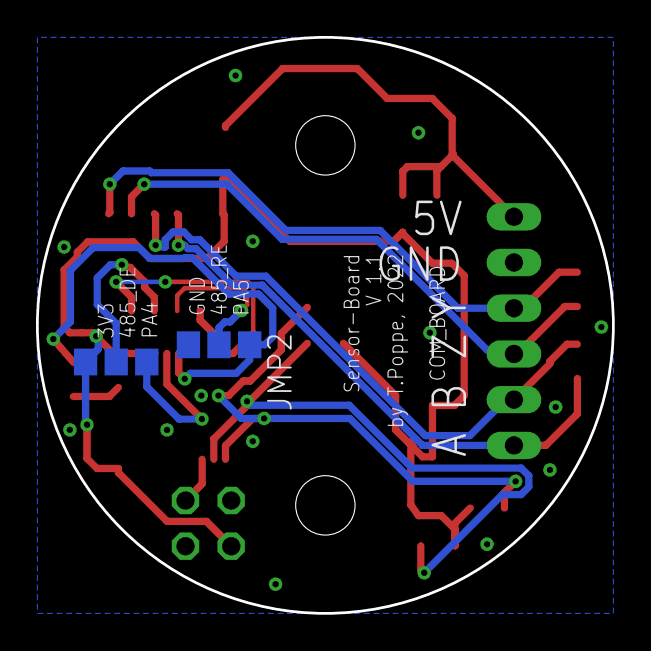
[picture p17: board ms5839_without_trub.brd from below]

Board: 2 copper layers, 32.0 x 32.0 mm, 27 parts (2 on the bottom side), 16 nets.
