topoppe/open-wales/Basismodule/lorawan/basestation_lorawan.brd

## EAGLE design Basismodule/lorawan/basestation_lorawan.brd (2023-01-30)

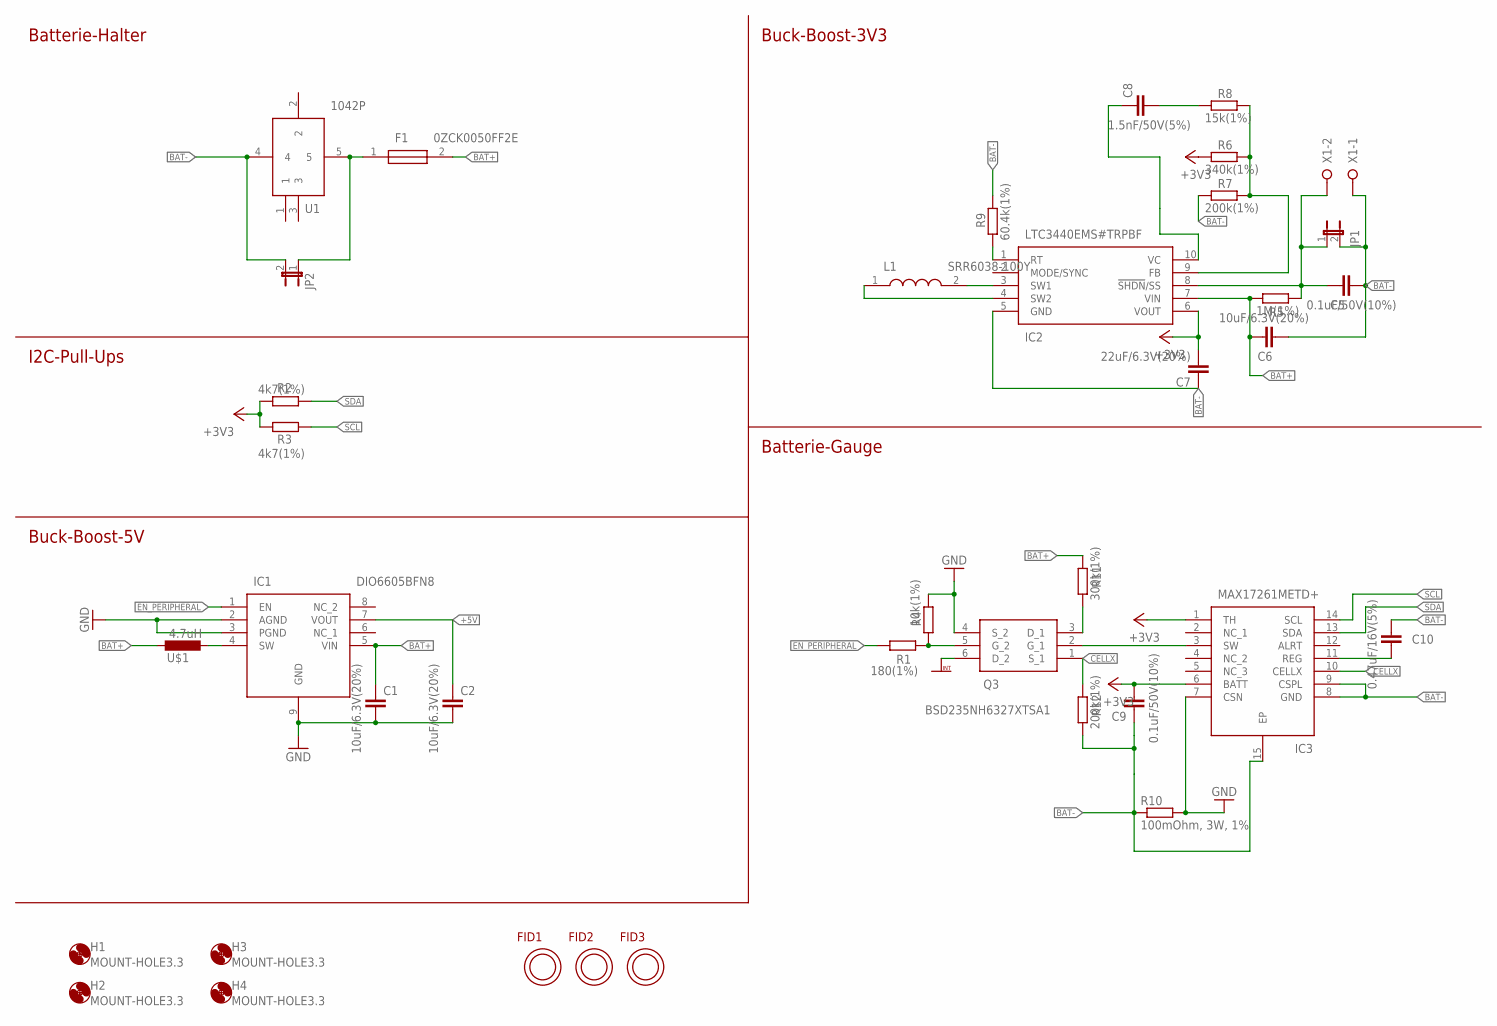
[picture p18: schematic basestation_lorawan.sch, sheet 1]

Parts:
C1, C2, C6: 10uF/6.3V(20%); C0805; MOUSER 963-JMK212BJ106MG-T
C5, C9: 0.1uF/50V(10%); C0805; MOUSER 80-C0805C104K5RACLR
C7: 22uF/6.3V(20%); C0805K; MOUSER 710-885012107005
C8: 1.5nF/50V(5%); C0805; MOUSER 80-C0805C152J5GAC
C10: 0.47uF/16V(5%); C0805; MOUSER 77-VJ0805Y474JXJTBC
F1: 0ZCK0050FF2E; FUSC2214X125N; MOUSER 530-0ZCK0050FF2E
FID1, FID2, FID3: OPEN-PNP-FIDUCIAL
H1, H2, H3, H4: MOUNT-HOLE3.3; 3,3
IC1: DIO6605BFN8; SON50P300X200X80-9N
IC2: LTC3440EMS#TRPBF; SOP50P490X110-10N
IC3: MAX17261METD+; SON40P300X300X80-15N
JP1, JP2: JP1E; JP1
L1: SRR6038-100Y; SRR6038330Y; MOUSER_PART_NUMBER 652-SRR6038-100Y
Q3: BSD235NH6327XTSA1; SOT65P210X100-6N
R1: 180(1%); M0805
R2, R3: 4k7(1%); M0805
R4: 10k(1%); M0805
R5: 1M(1%); M0805
R6: 340k(1%); M0805
R7, R12: 200k(1%); M0805
R8: 15k(1%); M0805
R9: 60.4k(1%); M0805
R10: 100mOhm, 3W, 1%; R2512; MOUSER 652-CRA2512FZR100ELF
R11: 300k(1%); M0805
U1: 1042P
U$1: 4.7uH; R0805; MOUSER 963-MBMK2520T4R7M
X1: W237-02P; W237-132

Connections:
+3V3: C7.2, C9.2, IC2.6 (VOUT), IC3.1 (TH), IC3.6 (BATT), R2.2, R3.2, R6.1; also elsewhere on the board
+5V: C2.1, IC1.7 (VOUT); also elsewhere on the board
BAT+: C1.1, C6.2, F1.2, IC1.5 (VIN), IC2.7 (VIN), R5.1, R11.2, U$1.1
BAT+_UNFUSED: F1.1, JP2.1, U1.5
BAT-: C5.2, C6.1, C7.1, C9.1, C10.1, IC2.5 (GND), IC3.8 (GND), IC3.9 (CSPL), IC3.15 (EP), JP1.2, JP2.2, R7.1, R9.2, R10.1, R12.1, U1.4, X1.1
CELLX: IC3.10 (CELLX), Q3.1 (S_1), R12.2
EN_PERIPHERAL: IC1.1 (EN), R1.2; also elsewhere on the board
GND: C1.2, C2.2, IC1.2 (AGND), IC1.3 (PGND), IC1.9 (GND), IC3.7 (CSN), Q3.4 (S_2), R4.2, R10.2; also elsewhere on the board
GNDINT: Q3.6 (D_2); also elsewhere on the board
unnamed: IC1.4 (SW), U$1.2
unnamed: Q3.5 (G_2), R1.1, R4.1
unnamed: IC2.3 (SW1), L1.2
unnamed: IC2.4 (SW2), L1.1
unnamed: IC2.9 (FB), R6.2, R7.2, R8.2
unnamed: C5.1, IC2.8 (!SHDN!/SS), JP1.1, R5.2, X1.2
unnamed: C8.2, R8.1
unnamed: C8.1, IC2.10 (VC)
unnamed: Q3.3 (D_1), R11.1
REG: C10.2, IC3.11 (REG)
RT: IC2.1 (RT), R9.1
SCL: IC3.14 (SCL), R3.1; also elsewhere on the board
SDA: IC3.13 (SDA), R2.1; also elsewhere on the board
SW: IC3.3 (SW), Q3.2 (G_1)

Notes on the sheet:
Batterie-Halter
I2C-Pull-Ups
Buck-Boost-5V
Buck-Boost-3V3
Batterie-Gauge

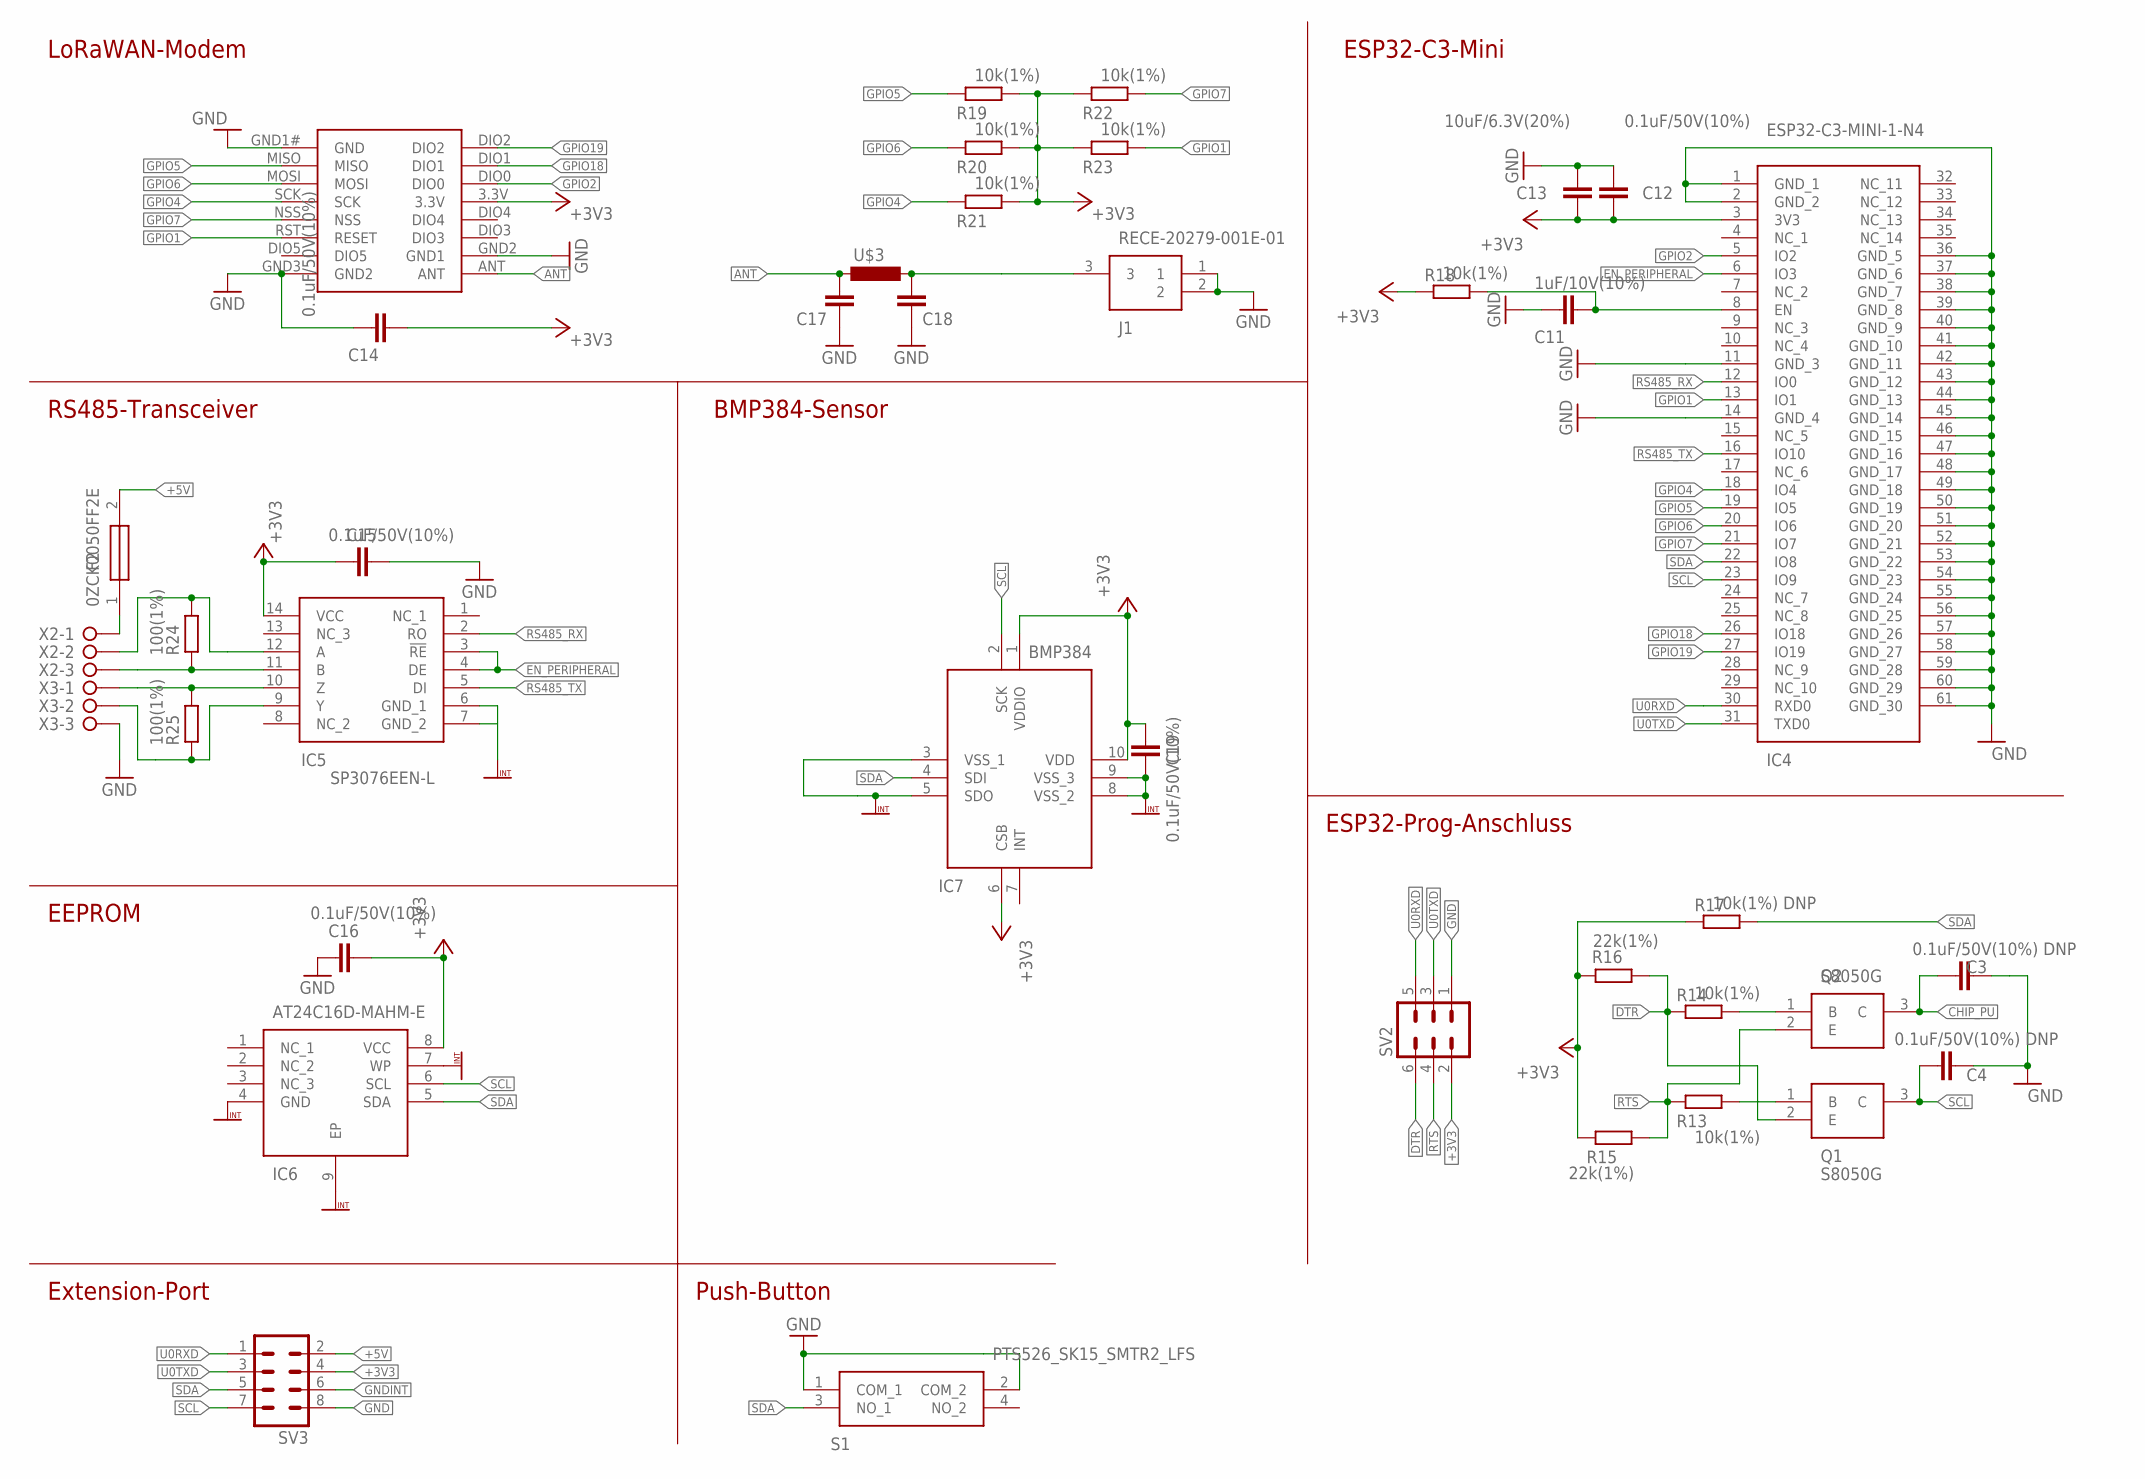
[picture p19: schematic basestation_lorawan.sch, sheet 2]

Parts:
C3, C4: 0.1uF/50V(10%) DNP; C0805; MOUSER 80-C0805C104K5RACLR
C11: 1uF/10V(10%); C0805; MOUSER 710-885012207078
C12, C14, C15, C16, C19: 0.1uF/50V(10%); C0805; MOUSER 80-C0805C104K5RACLR
C13: 10uF/6.3V(20%); C0805; MOUSER 963-JMK212BJ106MG-T
C17, C18: C-EUC0805K; C0805K
F2: 0ZCK0050FF2E; FUSC2214X125N; MOUSER 530-0ZCK0050FF2E
IC4: ESP32-C3-MINI-1-N4; ESP32C3MINI1N4; MOUSER 356-ESP32-C3-MINI1N4
IC5: SP3076EEN-L; SOIC127P600X175-14N
IC6: AT24C16D-MAHM-E; SON50P300X200X60-9N; MOUSER 579-AT24C16D-MAHM-E
IC7: BMP384
J1: RECE-20279-001E-01; RECE.20279.001E.01; MOUSER 960-RECE20279001E01
Q1, Q2: S8050G; SOT95P240X110-3N; MOUSER 750-SS8050-G
R13, R14, R18, R19, R20, R21, R22, R23: 10k(1%); M0805
R15, R16: 22k(1%); M0805
R17: 10k(1%) DNP; M0805
R24, R25: 100(1%); M0805
S1: PTS526_SK15_SMTR2_LFS; PTS526SK15SMTR2LFS; MOUSER 611-PTS526SK15SMR2L
SV2: MA03-2
SV3: MA04-2
U$2: RFM95W
U$3: L-0805; R0805
X2, X3: W237-3E

Connections:
+3V3: C12.1, C13.2, C14.1, C15.1, C16.2, C19.1, IC4.3 (3V3), IC5.14 (VCC), IC6.8 (VCC), IC7.1 (VDDIO), IC7.6 (CSB), IC7.10 (VDD), R15.2, R16.1, R17.2, R18.2, R19.1, R20.1, R21.1, R22.2, R23.2, SV2.2, SV3.4, U$2.3.3V; also elsewhere on the board
+5V: F2.2, SV3.2; also elsewhere on the board
A: IC5.12 (A), R24.2, X2.2
ANT: C17.1, U$2.ANT, U$3.1
B: IC5.11 (B), R24.1, X2.3
CHIP_PU: C3.2, C11.1, IC4.8 (EN), Q2.3 (C), R18.1
DTR: Q1.2 (E), R14.2, R16.2, SV2.6
EN_PERIPHERAL: IC4.6 (IO3), IC5.3 (!RE), IC5.4 (DE); also elsewhere on the board
GND: C3.1, C4.1, C11.2, C12.2, C13.1, C14.2, C15.2, C16.1, C17.2, C18.2, IC4.1 (GND_1), IC4.2 (GND_2), IC4.11 (GND_3), IC4.14 (GND_4), IC4.36 (GND_5), IC4.37 (GND_6), IC4.38 (GND_7), IC4.39 (GND_8), IC4.40 (GND_9), IC4.41 (GND_10), IC4.42 (GND_11), IC4.43 (GND_12), IC4.44 (GND_13), IC4.45 (GND_14), IC4.46 (GND_15), IC4.47 (GND_16), IC4.48 (GND_17), IC4.49 (GND_18), IC4.50 (GND_19), IC4.51 (GND_20), IC4.52 (GND_21), IC4.53 (GND_22), IC4.54 (GND_23), IC4.55 (GND_24), IC4.56 (GND_25), IC4.57 (GND_26), IC4.58 (GND_27), IC4.59 (GND_28), IC4.60 (GND_29), IC4.61 (GND_30), J1.1, J1.2, S1.1 (COM_1), S1.2 (COM_2), SV2.1, SV3.8, U$2.GND1# (GND), U$2.GND2 (GND1), U$2.GND3 (GND2), X3.3; also elsewhere on the board
GNDINT: C19.2, IC5.6 (GND_1), IC5.7 (GND_2), IC6.4 (GND), IC6.7 (WP), IC6.9 (EP), IC7.3 (VSS_1), IC7.5 (SDO), IC7.8 (VSS_2), IC7.9 (VSS_3), SV3.6; also elsewhere on the board
GPIO1: IC4.13 (IO1), R23.1, U$2.RST (RESET)
GPIO2: IC4.5 (IO2), U$2.DIO0
GPIO4: IC4.18 (IO4), R21.2, U$2.SCK
GPIO5: IC4.19 (IO5), R19.2, U$2.MISO
GPIO6: IC4.20 (IO6), R20.2, U$2.MOSI
GPIO7: IC4.21 (IO7), R22.1, U$2.NSS
GPIO18: IC4.26 (IO18), U$2.DIO1
GPIO19: IC4.27 (IO19), U$2.DIO2
unnamed: Q2.1 (B), R14.1
unnamed: Q1.1 (B), R13.1
unnamed: F2.1, X2.1
unnamed: C18.1, J1.3, U$3.2
RS485_RX: IC4.12 (IO0), IC5.2 (RO)
RS485_TX: IC4.16 (IO10), IC5.5 (DI)
RTS: Q2.2 (E), R13.2, R15.1, SV2.4
SCL: C4.2, IC4.23 (IO9), IC6.6 (SCL), IC7.2 (SCK), Q1.3 (C), SV3.7; also elsewhere on the board
SDA: IC4.22 (IO8), IC6.5 (SDA), IC7.4 (SDI), R17.1, S1.3 (NO_1), SV3.5; also elsewhere on the board
U0RXD: IC4.30 (RXD0), SV2.5, SV3.1
U0TXD: IC4.31 (TXD0), SV2.3, SV3.3
Y: IC5.9 (Y), R25.1, X3.2
Z: IC5.10 (Z), R25.2, X3.1

Notes on the sheet:
ESP32-C3-Mini
ESP32-Prog-Anschluss
LoRaWAN-Modem
RS485-Transceiver
EEPROM
Extension-Port
Push-Button
BMP384-Sensor
