topoppe/open-wales/Basismodule/lorawan/basestation_lorawan.brd

## EAGLE design Basismodule/lorawan/basestation_lorawan.brd (continued)

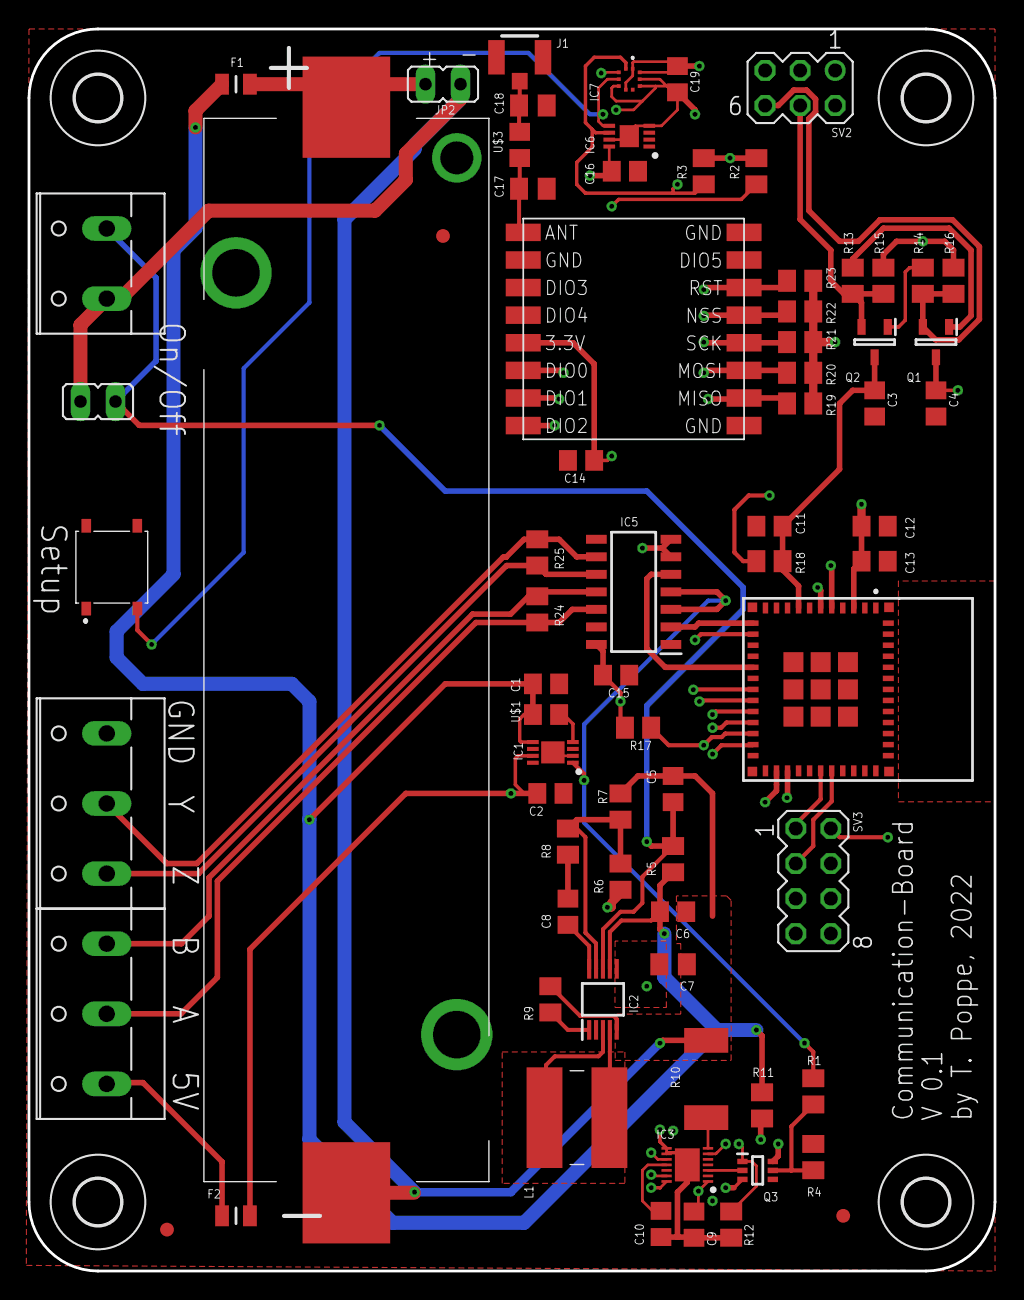
[picture p20: board basestation_lorawan.brd from above]

Board: 4 copper layers, 70.0 x 90.0 mm, 77 parts (0 on the bottom side), 47 nets.
