topoppe/open-wales/Basismodule/lorawan/firmware/src/lorawan.cpp

#include <arduino.h>
#include <lmic.h>
#include <hal/hal.h>
#include <SPI.h>
#include <Wire.h>
#include "credentials.h"

bool data_sent = false;

extern bool GOTO_DEEPSLEEP;

// Schedule TX every this many seconds
// Respect Fair Access Policy and Maximum Duty Cycle!
// https://www.thethingsnetwork.org/docs/lorawan/duty-cycle.html
// https://www.loratools.nl/#/airtime
unsigned TX_INTERVAL = 30;

static const u1_t PROGMEM APPEUI[8] = LORA_APPEUI;

// This should also be in little endian format, see above.
static const u1_t PROGMEM DEVEUI[8] = LORA_DEVEUI;

// This key should be in big endian format (or, since it is not really a
// number but a block of memory, endianness does not really apply). In
// practice, a key taken from ttnctl can be copied as-is.
static const u1_t PROGMEM APPKEY[16] = LORA_APPKEY;


// This EUI must be in little-endian format, so least-significant-byte
// first. When copying an EUI from ttnctl output, this means to reverse
// the bytes. For TTN issued EUIs the last bytes should be 0xD5, 0xB3,
// 0x70.
//static const u1_t PROGMEM APPEUI[8]={ 0x00, 0x00, 0x00, 0x00, 0x00, 0x00, 0x00, 0x00 };
void os_getArtEui (u1_t* buf) { memcpy_P(buf, APPEUI, 8);}

// This should also be in little endian format, see above.  0x70, 0xB3, 0xD5, 0x7E, 0xD0, 0x04, 0xCF, 0xAF
//static const u1_t PROGMEM DEVEUI[8]={ 0xEE, 0xCF, 0x04, 0xD0, 0x7E, 0xD5, 0xB3, 0x70 };
void os_getDevEui (u1_t* buf) { memcpy_P(buf, DEVEUI, 8);}

// This key should be in big endian format (or, since it is not really a
// number but a block of memory, endianness does not really apply). In
// practice, a key taken from ttnctl can be copied as-is.
//static const u1_t PROGMEM APPKEY[16] = { 0xAC, 0x21, 0xA0, 0xEE, 0x72, 0xA1, 0x0D, 0xD9, 0xC7, 0x88, 0xFC, 0x7F, 0x7F, 0x9E, 0xF4, 0x6C };
void os_getDevKey (u1_t* buf) {  memcpy_P(buf, APPKEY, 16);}




// Saves the LMIC structure during DeepSleep
RTC_DATA_ATTR lmic_t RTC_LMIC;

void SaveLMICToRTC(int deepsleep_sec)
{
    Serial.println(F("Save LMIC to RTC"));
    RTC_LMIC = LMIC;

    // ESP32 can't track millis during DeepSleep and no option to advanced millis after DeepSleep.
    // Therefore reset DutyCyles

    unsigned long now = millis();

    // EU Like Bands
#if defined(CFG_LMIC_EU_like)
    Serial.println(F("Reset CFG_LMIC_EU_like band avail"));
    for (int i = 0; i < MAX_BANDS; i++)
    {
        ostime_t correctedAvail = RTC_LMIC.bands[i].avail - ((now / 1000.0 + deepsleep_sec) * OSTICKS_PER_SEC);
        if (correctedAvail < 0)
        {
            correctedAvail = 0;
        }
        RTC_LMIC.bands[i].avail = correctedAvail;
    }

    RTC_LMIC.globalDutyAvail = RTC_LMIC.globalDutyAvail - ((now / 1000.0 + deepsleep_sec) * OSTICKS_PER_SEC);
    if (RTC_LMIC.globalDutyAvail < 0)
    {
        RTC_LMIC.globalDutyAvail = 0;
    }
#else
    Serial.println(F("No DutyCycle recalculation function!"));
#endif
}

void LoadLMICFromRTC()
{
    Serial.println(F("Load LMIC from RTC"));
    LMIC = RTC_LMIC;
}

void GoDeepSleep()
{
    Serial.println(F("Go DeepSleep"));
    //PrintRuntime();
    //Serial.flush();
    esp_sleep_enable_timer_wakeup(TX_INTERVAL * 1000000);
      SPI.transfer(0x01); // Send register location
  SPI.transfer(0x00);  // Send value to record into register
    esp_deep_sleep_start();
}


void do_send(osjob_t* j, const uint8_t input[]);

//
// For normal use, we require that you edit the sketch to replace FILLMEIN
// with values assigned by the TTN console. However, for regression tests,
// we want to be able to compile these scripts. The regression tests define
// COMPILE_REGRESSION_TEST, and in that case we define FILLMEIN to a non-
// working but innocuous value.
//
#ifdef COMPILE_REGRESSION_TEST
# define FILLMEIN 0
#else
# warning "You must replace the values marked FILLMEIN with real values from the TTN control panel!"
# define FILLMEIN (#dont edit this, edit the lines that use FILLMEIN)
#endif




static uint8_t mydata[] = "Hello, world!";
static osjob_t sendjob;

// Schedule TX every this many seconds (might become longer due to duty
// cycle limitations).
//const unsigned TX_INTERVAL = 60;

// Pin mapping for lmic
const lmic_pinmap lmic_pins = {
    .nss = 7,
    .rxtx = LMIC_UNUSED_PIN,
    .rst = 1,
    .dio = {2, 18, 19},   //{26, 33, 32},
};

void set_nss_pin(bool state){
    digitalWrite(lmic_pins.nss, state);
}

void lorawan_init(unsigned send_interval){
    TX_INTERVAL = send_interval;
    // LMIC init
    os_init();
    // Reset the MAC state. Session and pending data transfers will be discarded.
    LMIC_reset();
    if (RTC_LMIC.seqnoUp != 0)
    {
        LoadLMICFromRTC();
    }

    LMIC.dn2Dr = DR_SF9;

    // Start job (sending automatically starts OTAA too)
    //do_send(&sendjob);
}

void printHex2(unsigned v) {
    v &= 0xff;
    if (v < 16)
        Serial.print('0');
    Serial.print(v, HEX);
}

void onEvent (ev_t ev) {
    Serial.print(os_getTime());
    Serial.print(": ");
    switch(ev) {
        case EV_SCAN_TIMEOUT:
            Serial.println(F("EV_SCAN_TIMEOUT"));
            break;
        case EV_BEACON_FOUND:
            Serial.println(F("EV_BEACON_FOUND"));
            break;
        case EV_BEACON_MISSED:
            Serial.println(F("EV_BEACON_MISSED"));
            break;
        case EV_BEACON_TRACKED:
            Serial.println(F("EV_BEACON_TRACKED"));
            break;
        case EV_JOINING:
            Serial.println(F("EV_JOINING"));
            break;
        case EV_JOINED:
            Serial.println(F("EV_JOINED"));
            {
              u4_t netid = 0;
              devaddr_t devaddr = 0;
              u1_t nwkKey[16];
              u1_t artKey[16];
              LMIC_getSessionKeys(&netid, &devaddr, nwkKey, artKey);
              Serial.print("netid: ");
              Serial.println(netid, DEC);
              Serial.print("devaddr: ");
              Serial.println(devaddr, HEX);
              Serial.print("AppSKey: ");
              for (size_t i=0; i<sizeof(artKey); ++i) {
                if (i != 0)
                  Serial.print("-");
                printHex2(artKey[i]);
              }
              Serial.println("");
              Serial.print("NwkSKey: ");
              for (size_t i=0; i<sizeof(nwkKey); ++i) {
                      if (i != 0)
                              Serial.print("-");
                      printHex2(nwkKey[i]);
              }
              Serial.println();
            }
            // Disable link check validation (automatically enabled
            // during join, but because slow data rates change max TX
	    // size, we don't use it in this example.
            LMIC_setLinkCheckMode(0);
            break;
        /*
        || This event is defined but not used in the code. No
        || point in wasting codespace on it.
        ||
        || case EV_RFU1:
        ||     Serial.println(F("EV_RFU1"));
        ||     break;
        */
        case EV_JOIN_FAILED:
            Serial.println(F("EV_JOIN_FAILED"));
            break;
        case EV_REJOIN_FAILED:
            Serial.println(F("EV_REJOIN_FAILED"));
            break;
        case EV_TXCOMPLETE:
            Serial.println(F("EV_TXCOMPLETE (includes waiting for RX windows)"));
            if (LMIC.txrxFlags & TXRX_ACK)
              Serial.println(F("Received ack"));
            if (LMIC.dataLen) {
              Serial.print(F("Received "));
              Serial.print(LMIC.dataLen);
              Serial.println(F(" bytes of payload"));
            }
            // Schedule next transmission
            //os_setTimedCallback(&sendjob, os_getTime()+sec2osticks(TX_INTERVAL), do_send);
            data_sent = true;
            GOTO_DEEPSLEEP = true;
            break;
        case EV_LOST_TSYNC:
            Serial.println(F("EV_LOST_TSYNC"));
            break;
        case EV_RESET:
            Serial.println(F("EV_RESET"));
            break;
        case EV_RXCOMPLETE:
            // data received in ping slot
            Serial.println(F("EV_RXCOMPLETE"));
            break;
        case EV_LINK_DEAD:
            Serial.println(F("EV_LINK_DEAD"));
            break;
        case EV_LINK_ALIVE:
            Serial.println(F("EV_LINK_ALIVE"));
            break;
        /*
        || This event is defined but not used in the code. No
        || point in wasting codespace on it.
        ||
        || case EV_SCAN_FOUND:
        ||    Serial.println(F("EV_SCAN_FOUND"));
        ||    break;
        */
        case EV_TXSTART:
            Serial.println(F("EV_TXSTART"));
            break;
        case EV_TXCANCELED:
            Serial.println(F("EV_TXCANCELED"));
            break;
        case EV_RXSTART:
            /* do not print anything -- it wrecks timing */
            break;
        case EV_JOIN_TXCOMPLETE:
            Serial.println(F("EV_JOIN_TXCOMPLETE: no JoinAccept"));
            break;

        default:
            Serial.print(F("Unknown event: "));
            Serial.println((unsigned) ev);
            break;
    }
}

void do_send(osjob_t* j, uint8_t input[], int input_size){
    // Check if there is not a current TX/RX job running
    if (LMIC.opmode & OP_TXRXPEND) {
        Serial.println(F("OP_TXRXPEND, not sending"));
    } else {
        // Prepare upstream data transmission at the next possible time.
        data_sent = false;
        LMIC_setTxData2(1, input, input_size, 0);
        Serial.println(F("Packet queued"));
        while (!data_sent)
        {
            os_runloop_once();
        }
uint8_t mydata[] = "Hello, world!";

    }
    // Next TX is scheduled after TX_COMPLETE event.
}

void send_lorawan_data(uint8_t input[], int input_size)
{
     //os_runloop_once();
     do_send(&sendjob, input,input_size);
}

void shutdown_lorawa(){
    LMIC_shutdown();
}
