topoppe/open-wales/(notices)

Notices in the files:
parts and their libraries:
COPYRIGHT: Copyright (C) 2022 Ultra Librarian. All rights reserved.
diy-modules: Released under the Creative Commons Attribution 4.0 International License: http://creativecommons.org/licenses/by/4.0
